OAreiqat/SDP23_Team5/SDP23_Team5_Website/assets/img/Team Members/Shira.jpg

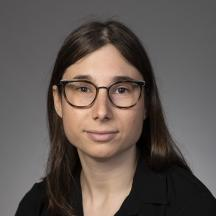
SDP23_Team5_Website/assets/img/Team Members/Shira.jpg
