OAreiqat/SDP23_Team5/SDP23_Team5_Website/assets/docs/CDR_Presentation.pdf

# CDR

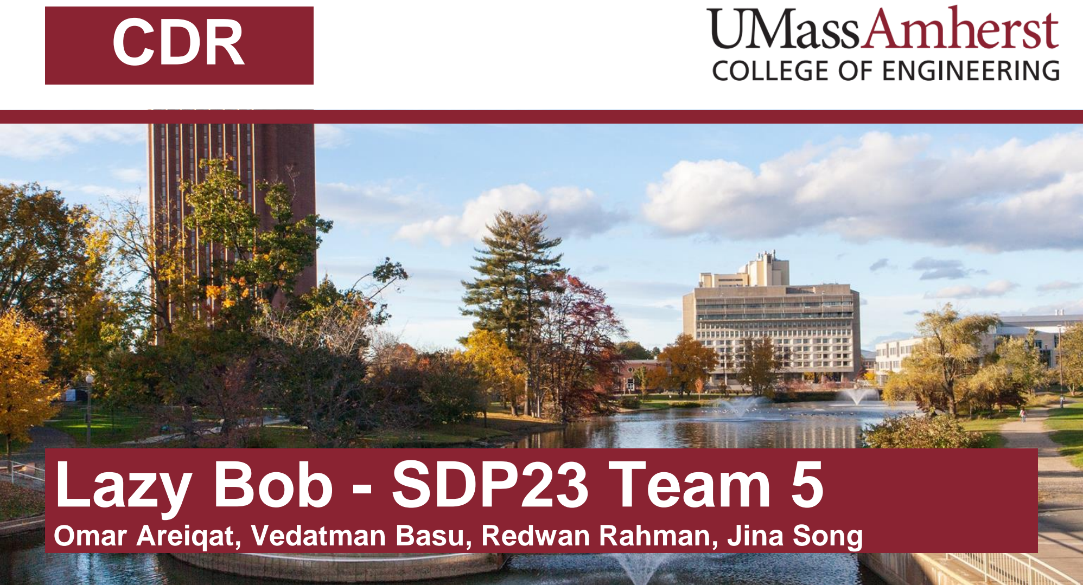
[picture p7: page 1]

# Lazy Bob - SDP23 Team 5

## Omar Areiqat, Vedatman Basu, Redwan Rahman, Jina Song

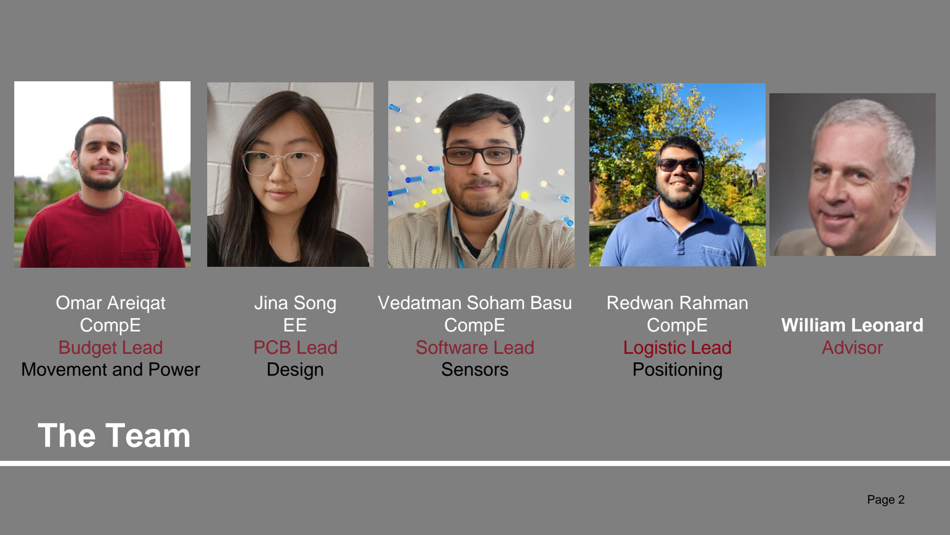
[picture p8: page 2]

# The Team

Omar Areiqat
CompE
Budget Lead
Movement and Power

Jina Song
EE
PCB Lead
Design

Vedatman Soham Basu
CompE
Software Lead
Sensors

Redwan Rahman
CompE
Logistic Lead
Positioning

William Leonard
Advisor

# Problem Statement

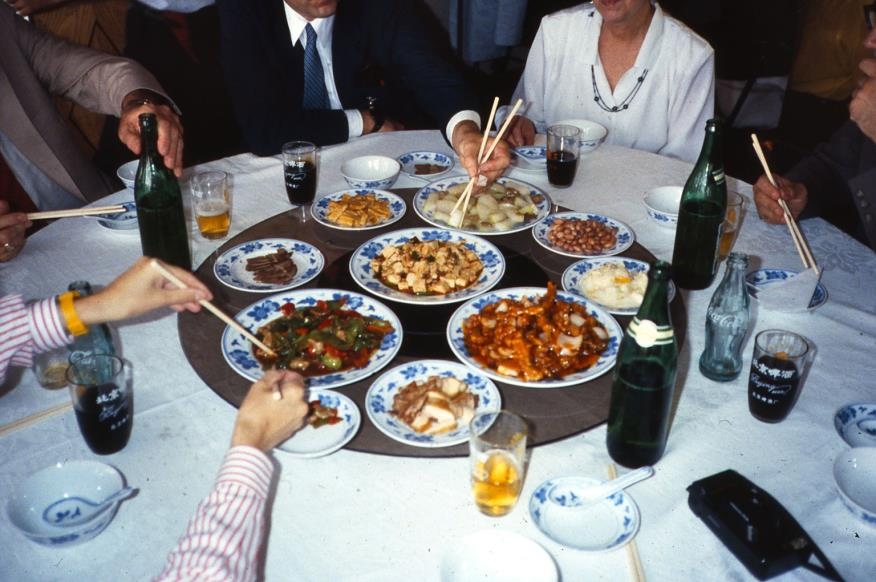
[picture p9: figure]

## Some people struggle with mundane actions in life, such as passing dishes on

a large table.

## Lazy Susans are nice, but only work on round tables and requires user to have

reach.

## What if there was a small, portable device that can move dishes across any table of arbitrary shape?

https://en.wikipedia.org/wiki/Lazy_Susan Page 3

# Our Solution

## “Lazy Bob”: A moving coaster that approaches the user when

called.

## 1. Stably transport items around a table to different users

## 1. Provide a simple way to interface with all coasters

## 1. Adapt to the environment

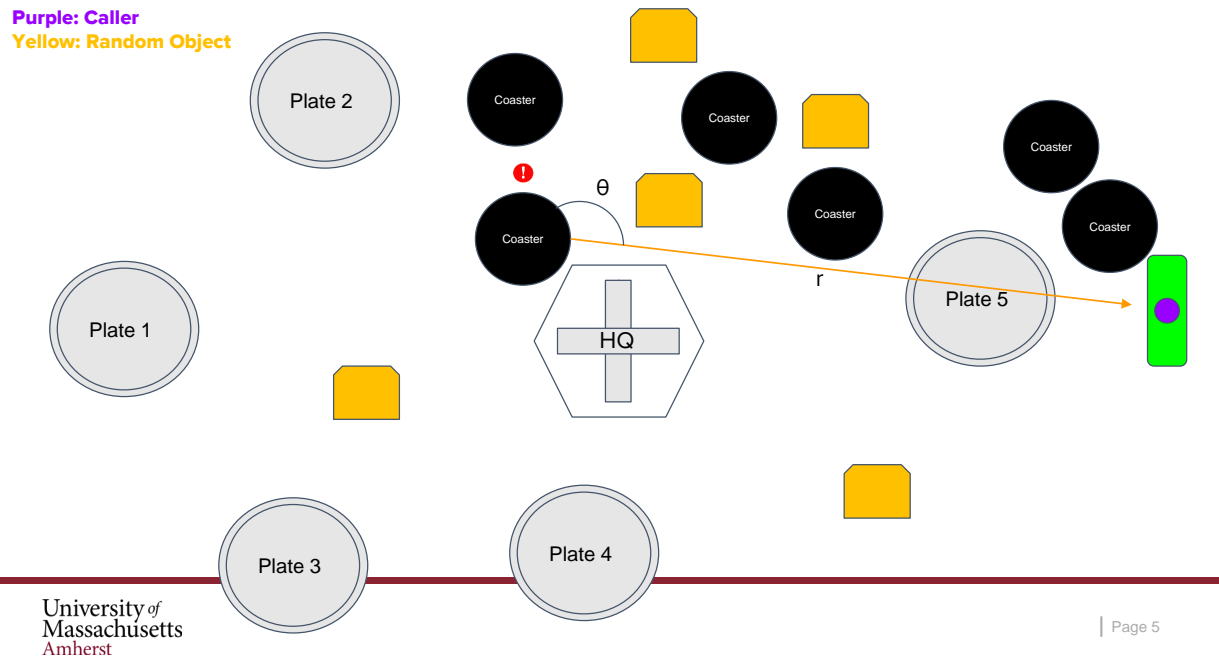
[picture p10: page 5]
Coaster; Plate 5; Plate 3; Plate 1; Plate 4; Plate 2

Purple: Caller
Yellow: Random Object

# Functional and Design

# Specification

# System Specifications: Functional

1. Mostly full container of liquid doesn’t spill when
moving
1. Transport items without the items falling off
1. Detect the edges of the table and avoid falling off
1. Avoid objects that are in the coaster’s moving path
1. Arrive at the caller to an accuracy of 10 cm from the edge of the coaster
1. Support up to 3 lbs.

### Test Plan

1. Place an 80% full glass/bowl of water and visibly check that the moving coaster doesn’t spill
1. Put objects on moving coaster and watch if object falls
1. Watch if the moving coaster falls off when caller is away from the table
1. Put objects in path and check if moving coaster bumps into object
1. Use a tape measure to check the distance from destination
1. Place an object that weighs 3 lbs and check if system is stable while moving

# System Specifications: Design

### Test Plan

7. Press both callers and see if the coaster follows
first-in, first-out sequence
8. Use tape measure to check coaster size
9. Find and put on irregular shaped tables and check
if they fall off
10. Line up objects to allow no path to caller, see if
system notifies caller
7. System supports at least 2 callers at the same
time
8. Coaster diameter is within 30 cm
9. Be able to use the moving coaster regardless of
table shape
10. If no path to caller is available, indicate to caller

# Block Diagrams

# Hardware Block Diagram

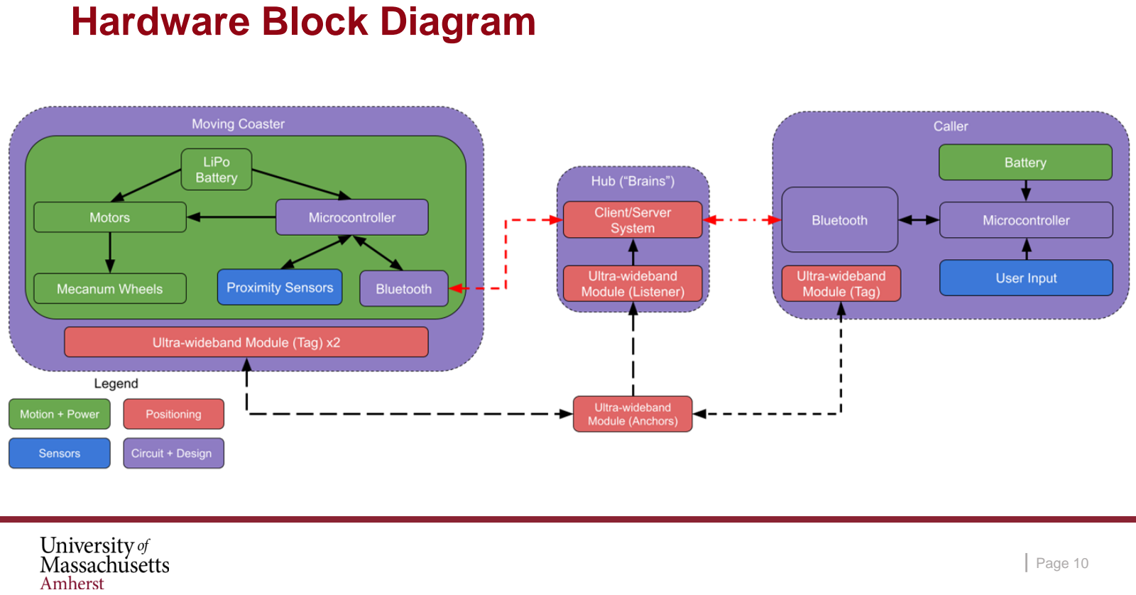
[picture p11: page 10]

# Software Block Diagram

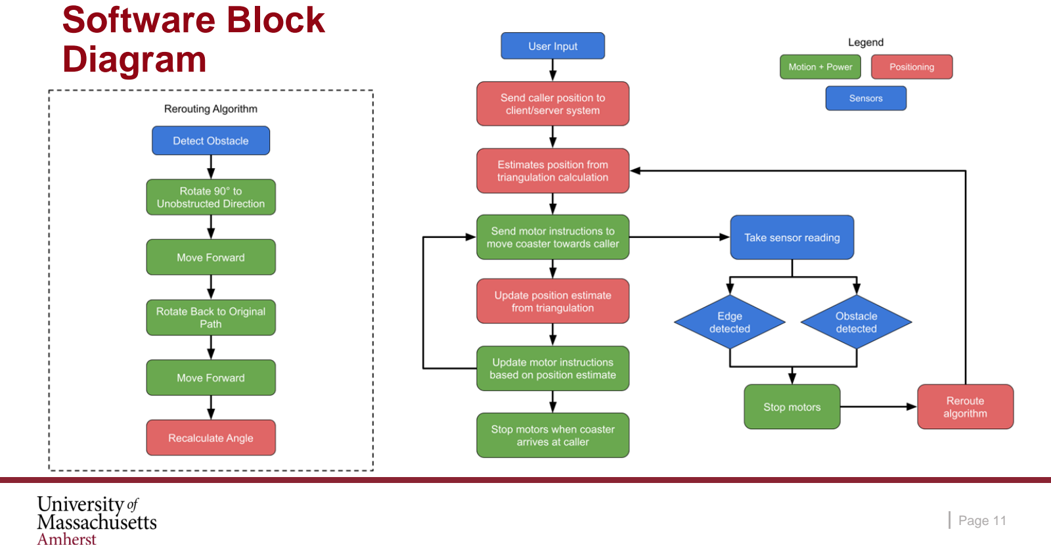
[picture p12: page 11]

# System Hardware

# Coaster

# Coaster: MDR

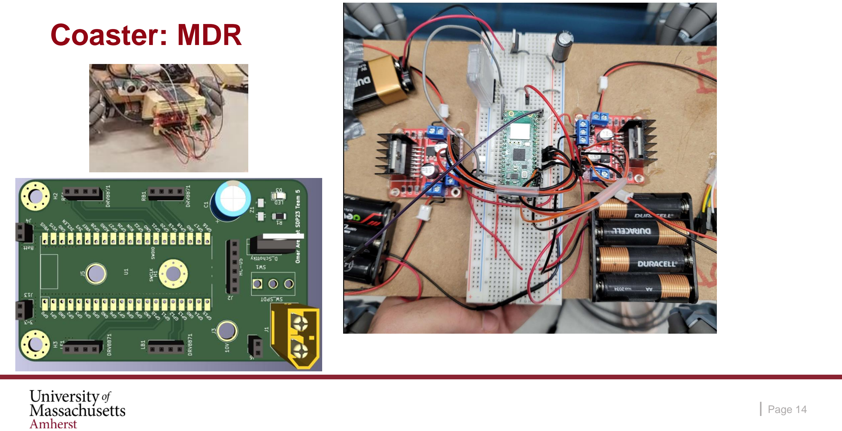
[picture p13: page 14]

# Coaster: CDR

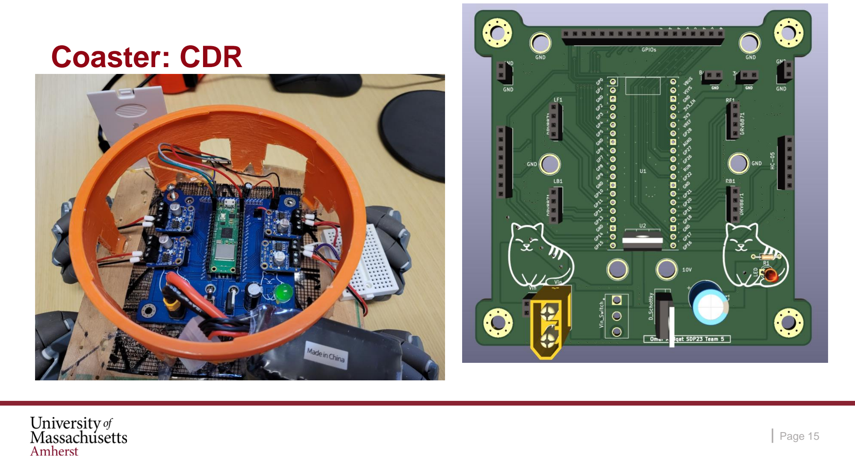
[picture p14: page 15]

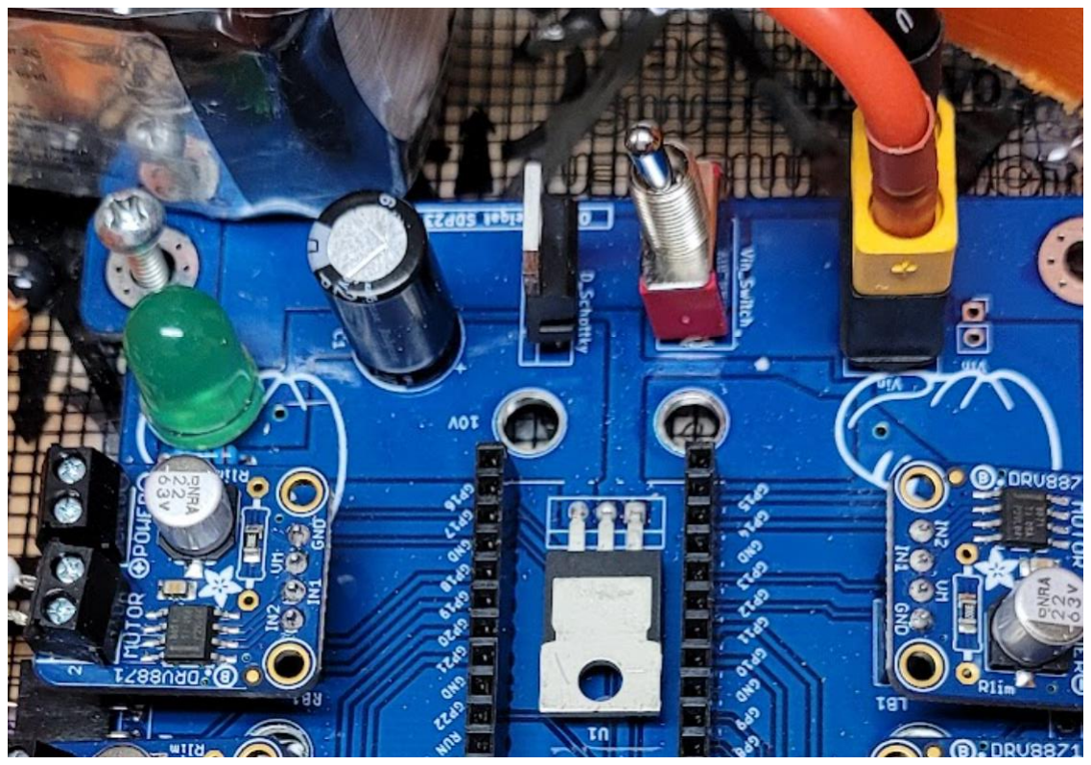
[picture p15: figure]

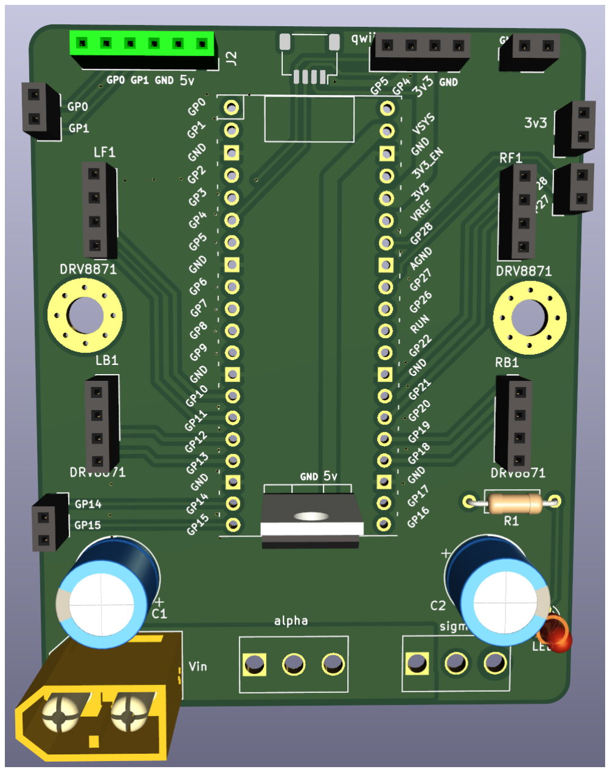
[picture p16: figure]

# Coaster: FPR PCB

# Caller

# Subsystem: Caller PCB

MDR | CDR | FPR

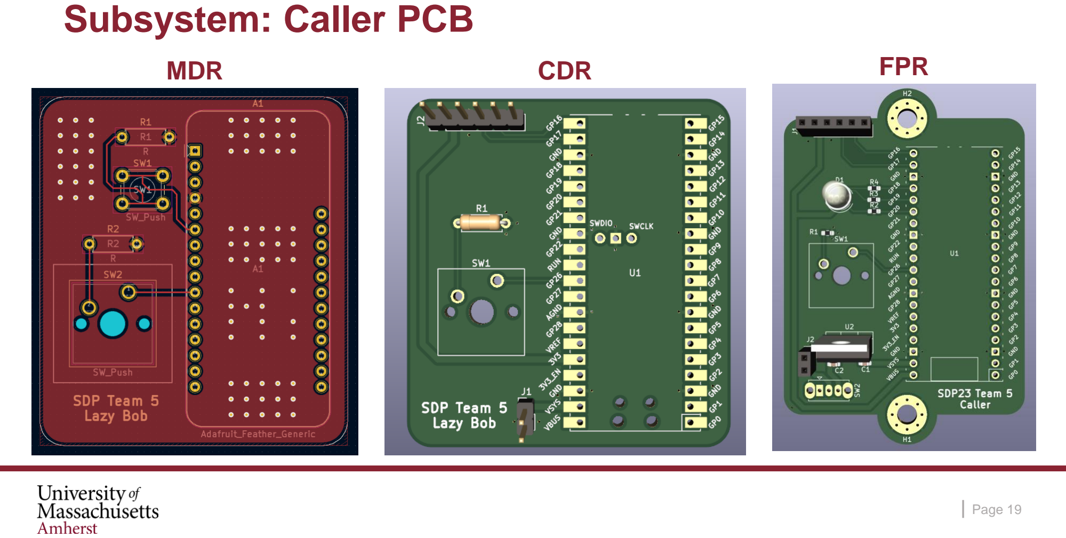
[picture p17: page 19]

# Sensors

# Subsystem: Collision and Cliff Detection

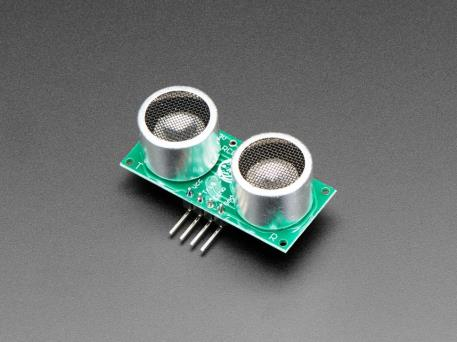
[picture p18: figure]

## - Ultrasonic

## - Collision detection (CDR) - Has not changed from before

## - Light ToF

## - Edge Detection (CDR) - Collision Detection (FPR) - Easy to implement many at a time

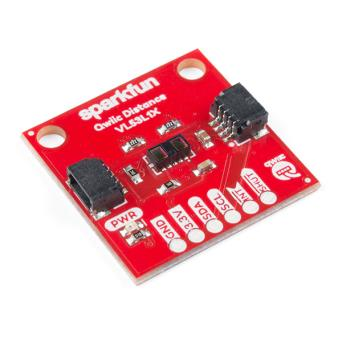
[picture p19: figure]

https://www.sparkfun.com/products/14722 Page 21

# Positioning and Rerouting

## - Ultra Wideband Sensor

# Subsystem: Positioning

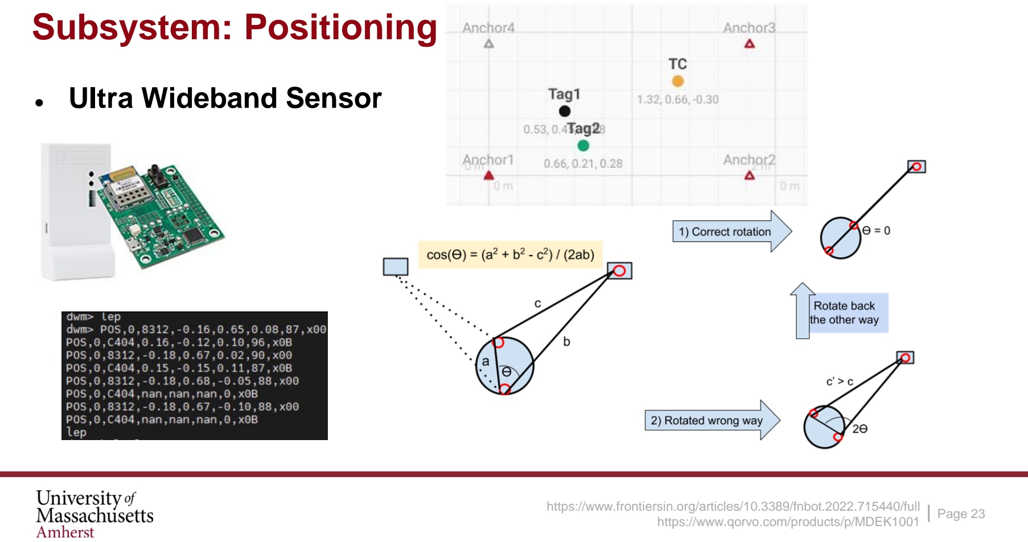
[picture p20: page 23]

https://www.frontiersin.org/articles/10.3389/fnbot.2022.715440/fullhttps://www.qorvo.com/products/p/MDEK1001 Page 23

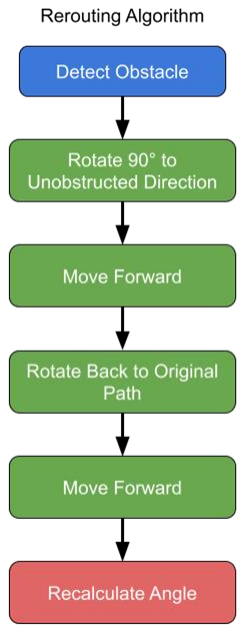
[picture p21: figure]

# Rerouting Block Diagram

# Subsystem: Algorithm

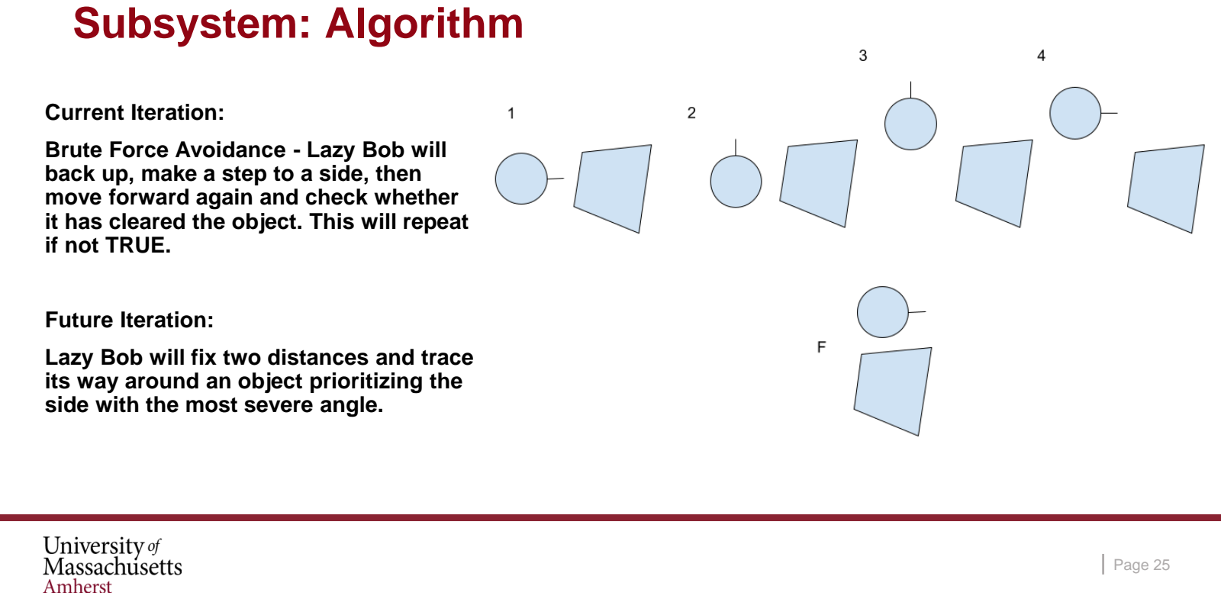
[picture p22: page 25]

Current Iteration:

Brute Force Avoidance - Lazy Bob will back up, make a step to a side, then move forward again and check whether it has cleared the object. This will repeat if not TRUE.

Future Iteration:

Lazy Bob will fix two distances and trace its way around an object prioritizing the side with the most severe angle.

# FPR Deliverables

## 1. Improved consistency on movement

## a. Move movement controls to the coaster itself for better consistency

## 1. Better Rerouting Algorithm

## a. Using more sensors, implement a better way to navigate

## 1. 2nd Caller

## 4. Chassis for Coaster

## a. 3D print chassis for each part of the system

## 5. PCB Plans

## a. Motion - Further optimizations

## b. User input - Add 5V and LED

# Design: Chassis (FPR)

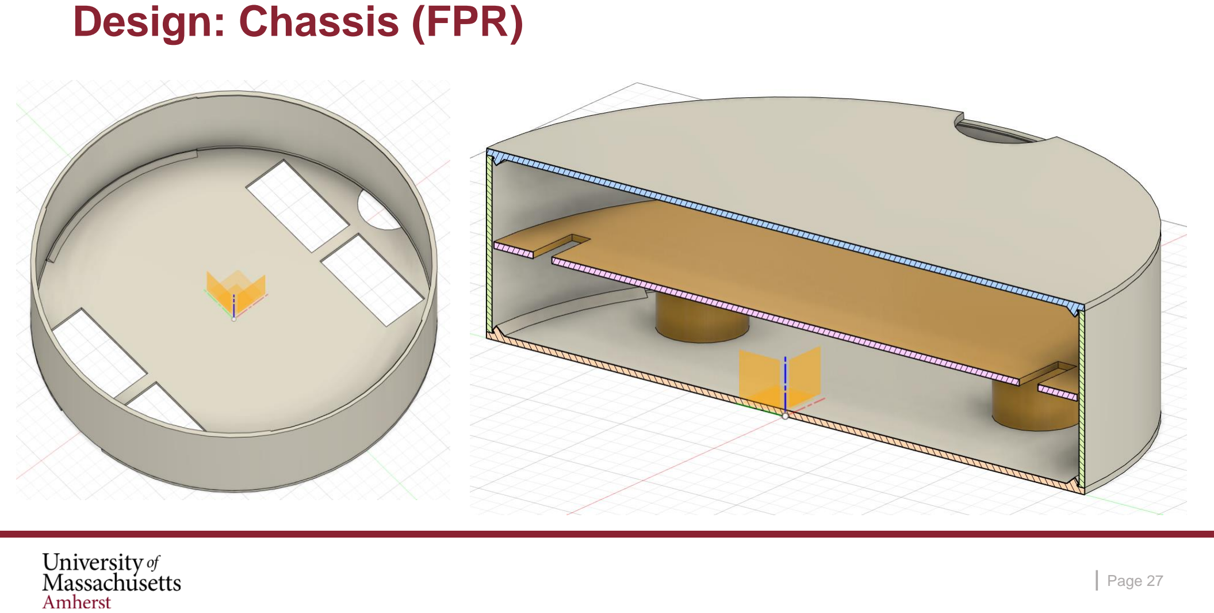
[picture p23: page 27]

# Design: Chassis (FPR)

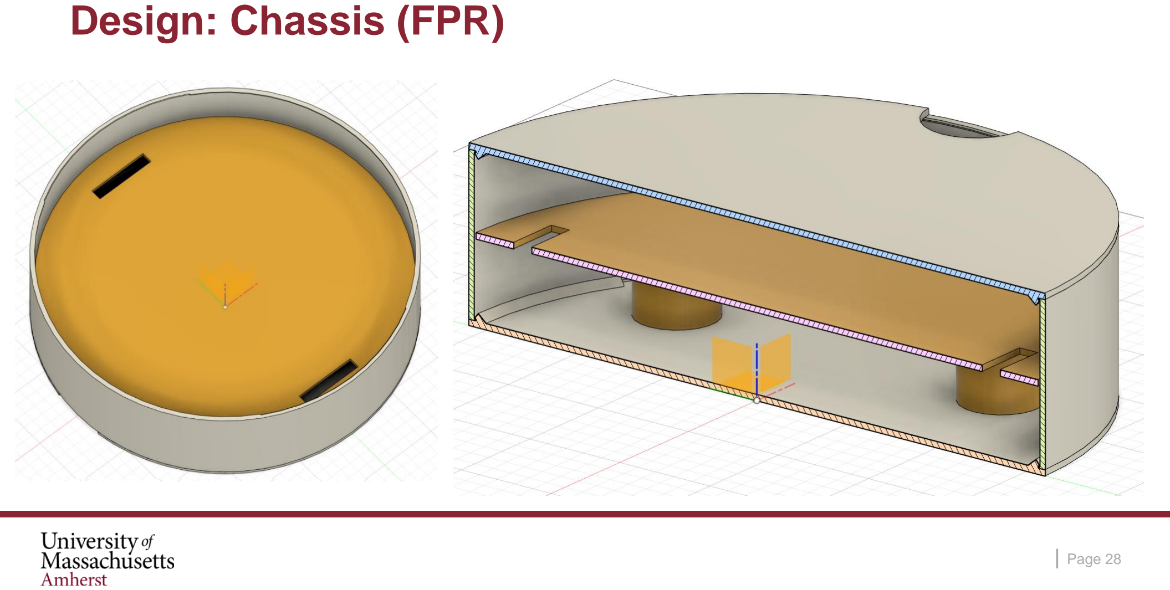
[picture p24: page 28]

# Design: Chassis (FPR)

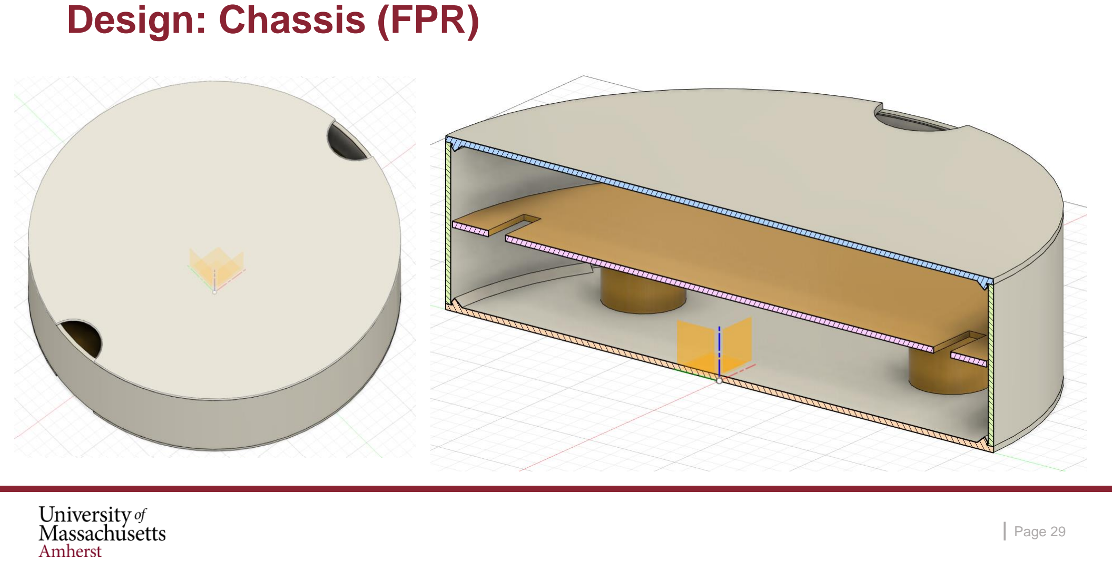
[picture p25: page 29]

# SDP Budget Used

Purchasing List
Item Name | Link | Price $ (w/Tax & Ship)
UWB DIY Starter Kit | Tindie (https://www.tindie.com/products/petteemfg/ultra-wideband-rtls-uwb-diy-starter-kit/) | 74.98
2 x Pico W | Digikey | 12
Gina PCB1 | JLC | 22.05
Gina PCBs 2 | JLC | 15.44
Omar PCB1 | JLC | 6.5
Omar PCB2 | JLC | 6.76
6 Dof Sensors | Amazon | 15.95
10x HC05 | Amazon | 37.98
3D Filament | Amazon | 38.99
New Wheels | Adafruit | 28.17
$258.82

Development Cost - per set of Brains, 1 Coaster, and 2 Callers

Coaster List
Item Name | Source | Price $ (with tax and shipping)
Qorvo UWB Kit | Qorvo | 170
3 x Pico W | Wouter | 18
PCBs | JLCPCB | 10
Sensors | M5 | 25
Sensors | M5 | 25
8x RCR132a | Amazon | 27
Motors and Wheels | Amazon | 50
Raspberry Pi 4 | M5 | 100
Misc. Hardware | Misc | 30
Lipo | M5 | 20
$475.00

# Gantt Chart

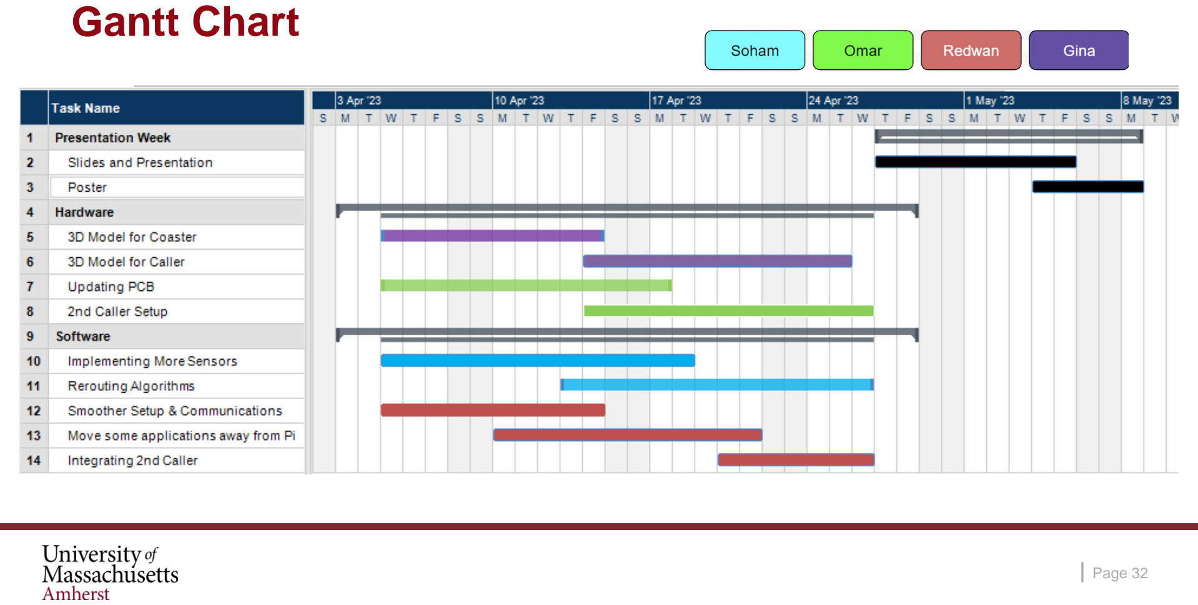
[picture p26: page 32]

# Videos

## Straight Shot:

https://drive.google.com/file/d/141u86p3lzujfCnuI5bPtXzJ-QYSLi3L_/view?usp=sharing

## Obstacle Avoidance:

https://drive.google.com/file/d/14BBHoazjFHobzXkXQCEPxUCetjSHFlHe/view?usp=sharing

# QUESTIONS & ANSWERS

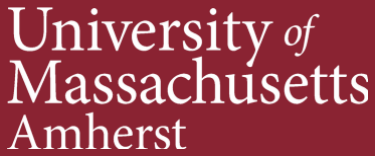
[picture p27: figure]
