OAreiqat/SDP23_Team5/SDP23_Team5_Website/assets/docs/FPR_Presentation.pdf

# FPR

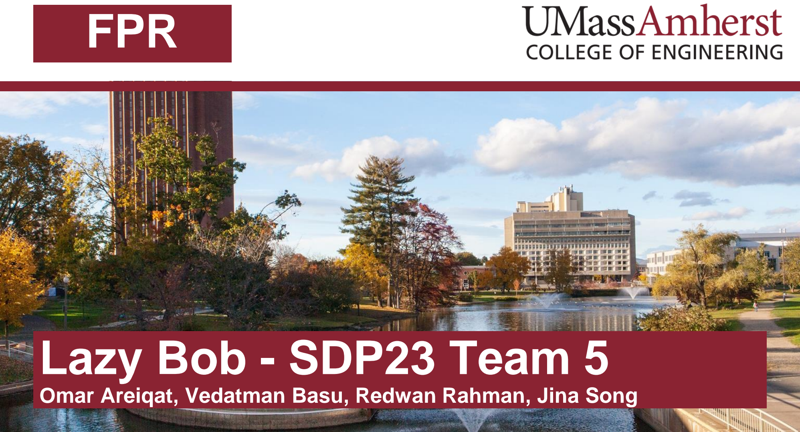
[picture p28: page 1]

# Lazy Bob - SDP23 Team 5

## Omar Areiqat, Vedatman Basu, Redwan Rahman, Jina Song

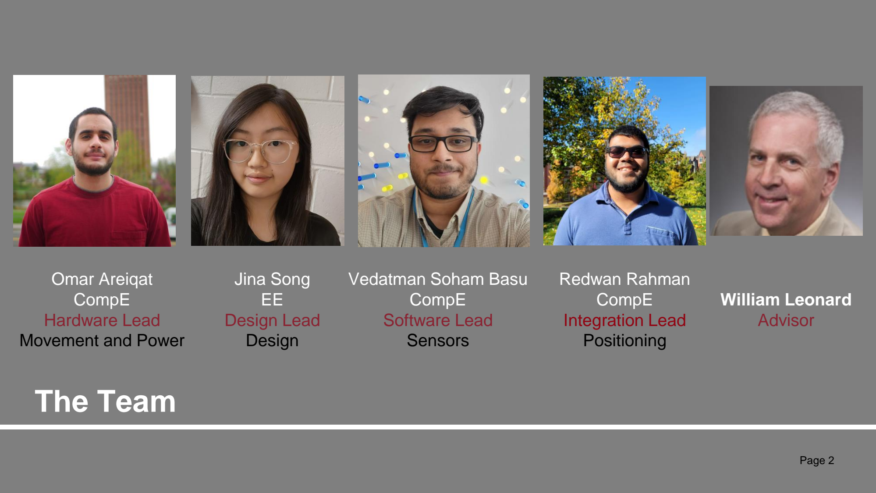
[picture p29: page 2]

# The Team

Omar Areiqat
CompE
Hardware Lead
Movement and Power

Jina Song
EE
Design Lead
Design

Vedatman Soham Basu
CompE
Software Lead
Sensors

Redwan Rahman
CompE
Integration Lead
Positioning

William Leonard
Advisor

# Problem Statement


## Some people struggle with mundane actions in life, such as passing dishes on

a large table.

## Lazy Susans are nice, but only work on round tables and requires user to have

reach.

## What if there was a small, portable device that can move dishes across any table of arbitrary shape?

https://en.wikipedia.org/wiki/Lazy_Susan Page 3

# Our Solution

## “Lazy Bob”: A moving coaster that approaches the user when

called.

## 1. Stably transport items around a table to different users

## 1. Provide a method for the user to call the moving coaster

## 1. Adapt to the environment

# Proposed System

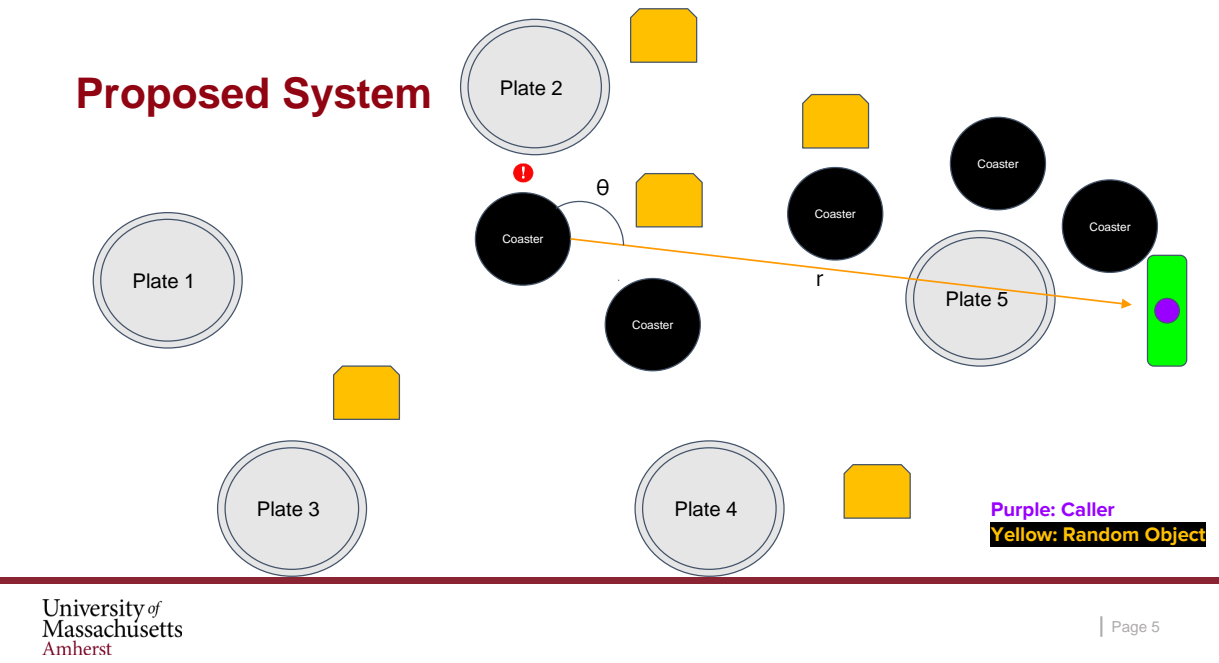
[picture p30: page 5]
Coaster; Plate 5; Plate 3; Plate 1; Plate 4; Plate 2

Purple: Caller
Yellow: Random Object

# Delivered System

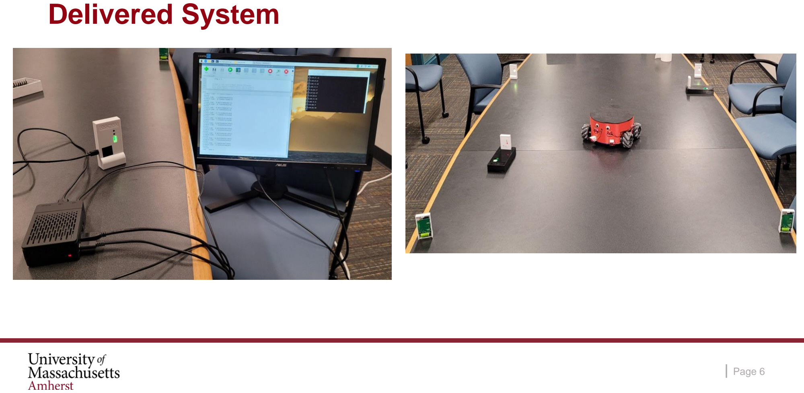
[picture p31: page 6]

## Pic of pi + monitor

## Overview shot

# System Specification

# System Specifications

1. Mostly full container of liquid doesn’t spill when moving
1. Transport items without the items falling off
1. Detect the edges of the table and avoid falling off
1. Avoid objects that are in the coaster’s moving path
1. Arrive at the caller to an accuracy of 15 cm between the closest points of the coaster and caller

### Test Plan

1. Place an 80% full glass/bowl of water and visibly check that the moving coaster doesn’t spill
1. Put objects on moving coaster and watch if object falls
1. Watch if the moving coaster falls off when caller is away from the table
1. Put objects in path and check if moving coaster bumps into object
1. Use a tape measure to check the distance from destination

# System Specifications

### Test Plan

6. Place an object that weighs 3 lbs and check if
system is stable while moving
7. Press both callers and see if the coaster moves
to the first caller only
8. Use tape measure to check coaster size
9. Find and put on irregular shaped tables and check
if it falls off
6. Support up to 3 lbs
7. System supports at least 2 callers at the same
time
8. Coaster diameter is within 30 cm
9. Be able to use the moving coaster regardless of
table shape

# Block Diagrams

# Hardware Block Diagram

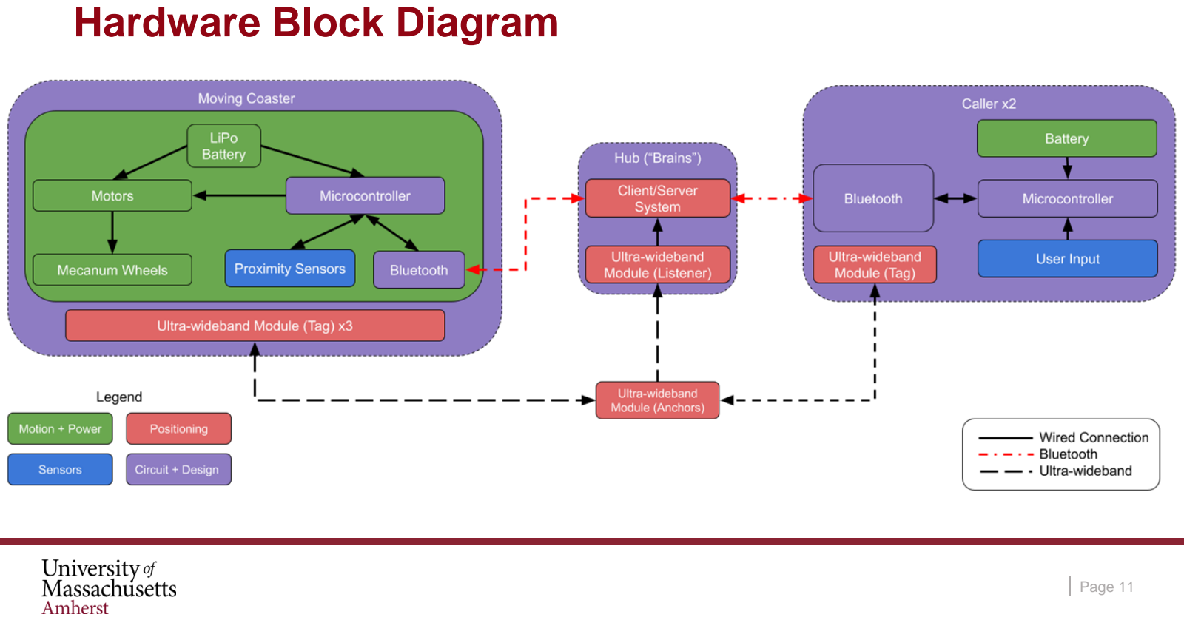
[picture p32: page 11]

# Software Block Diagram

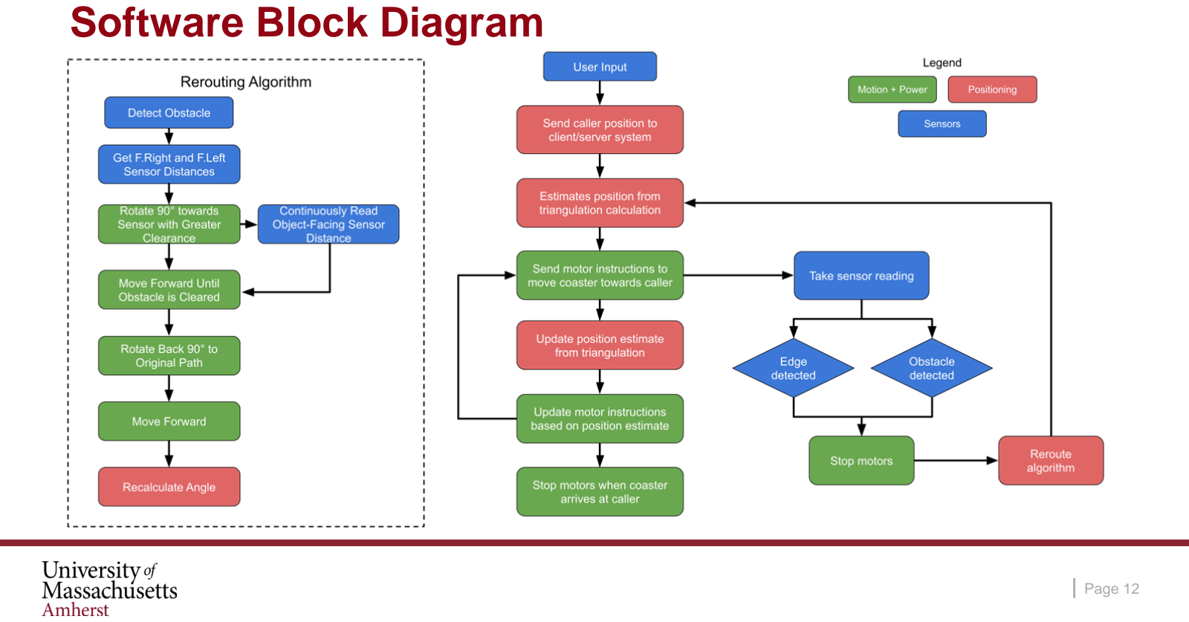
[picture p33: page 12]

# System Hardware

# Coaster

# Coaster: MDR

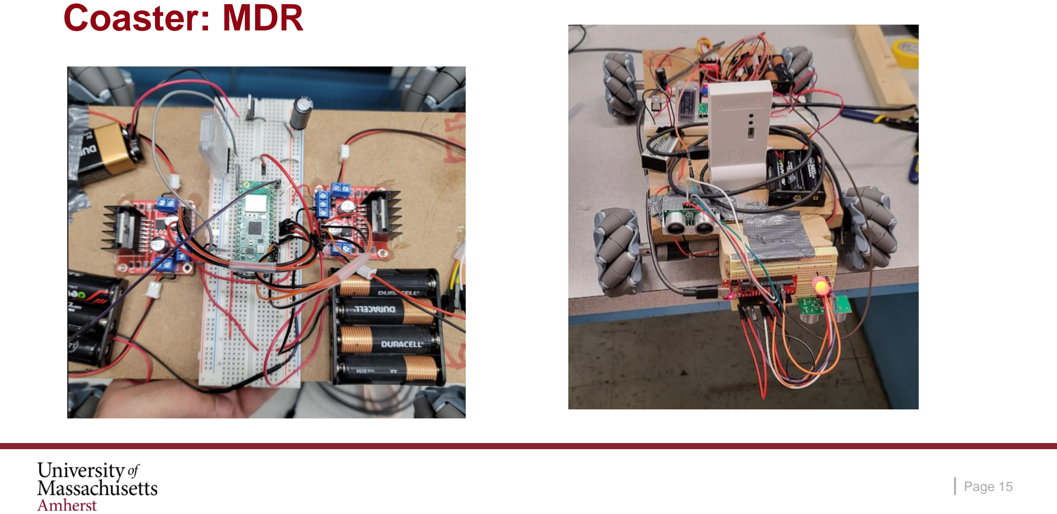
[picture p34: page 15]

# Coaster: CDR

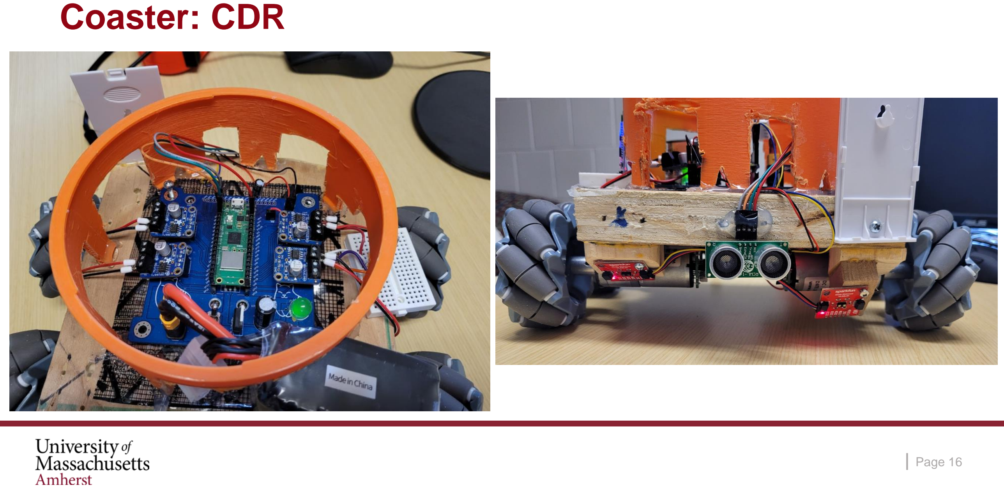
[picture p35: page 16]

# Coaster: FPR

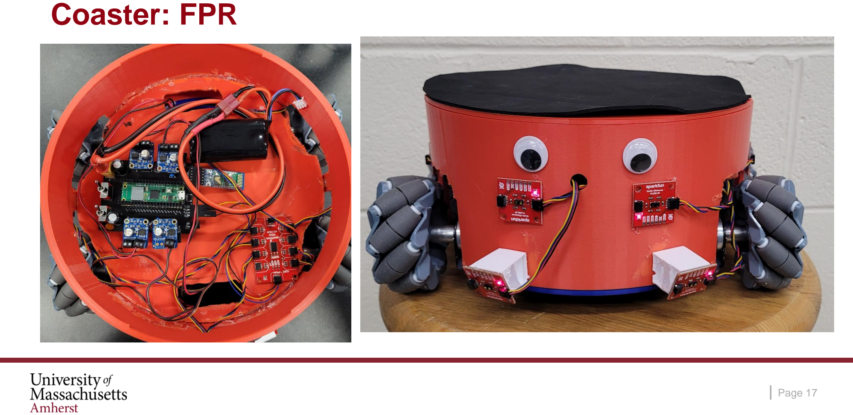
[picture p36: page 17]

# Callers

# Callers: MDR

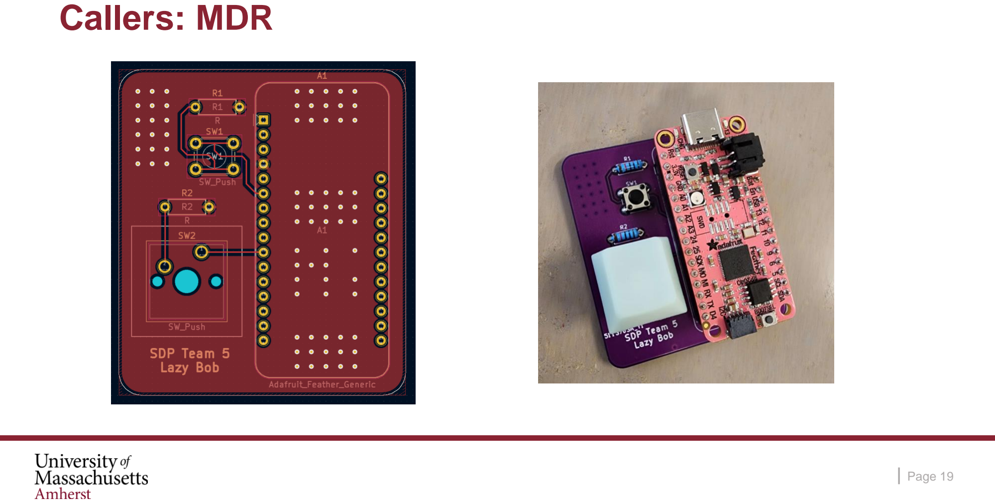
[picture p37: page 19]

# Callers: CDR

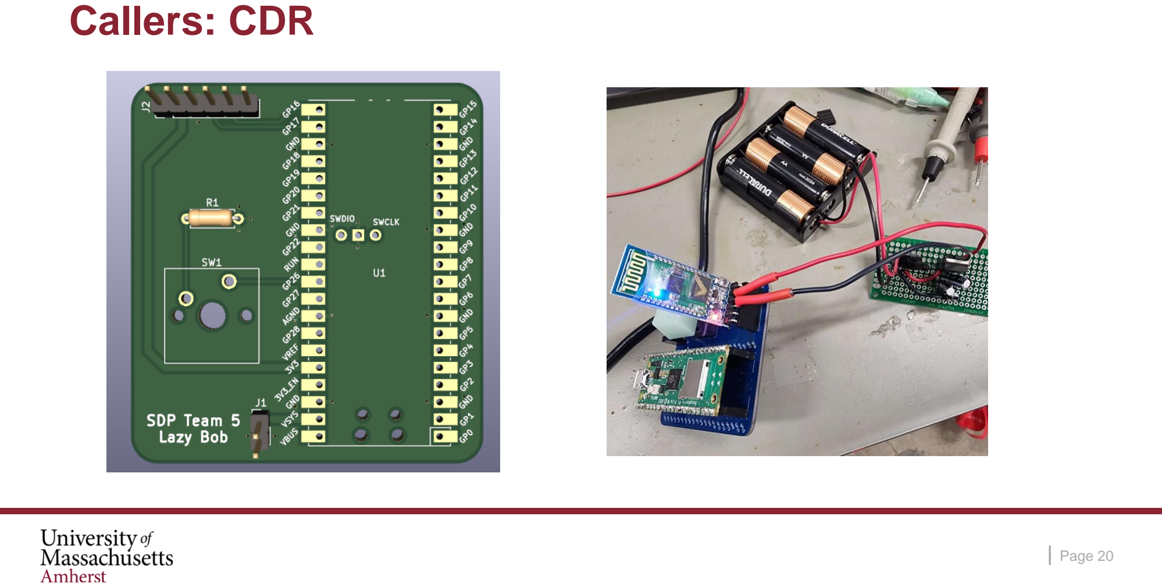
[picture p38: page 20]

# Callers: FPR

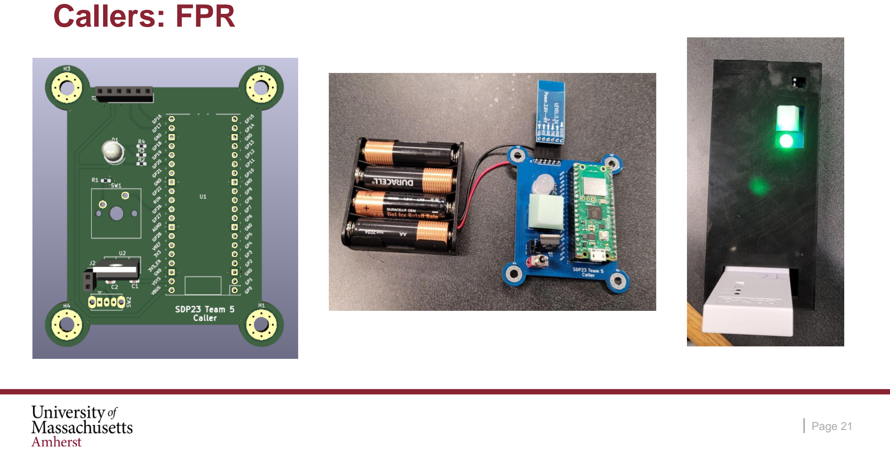
[picture p39: page 21]

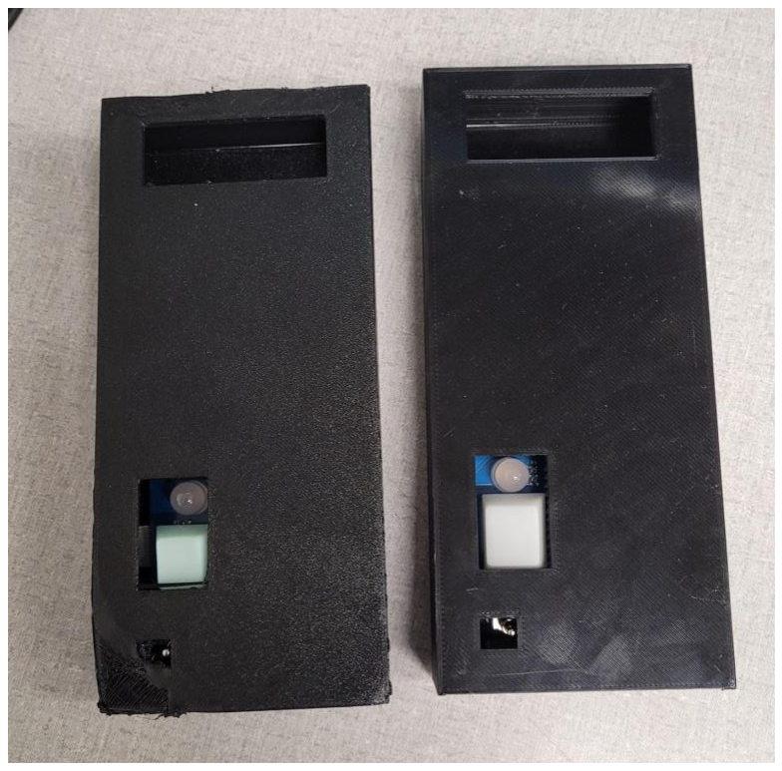
[picture p40: figure]

## - Only 1 caller may request the coaster at a time

## - All other calls are ignored when in use

## - LED color signifies current status

## - Green = Ready - Blue = On The Way - Red = Busy

# Callers: Multiple Implementation

# The “Brains”

# The “Brains”

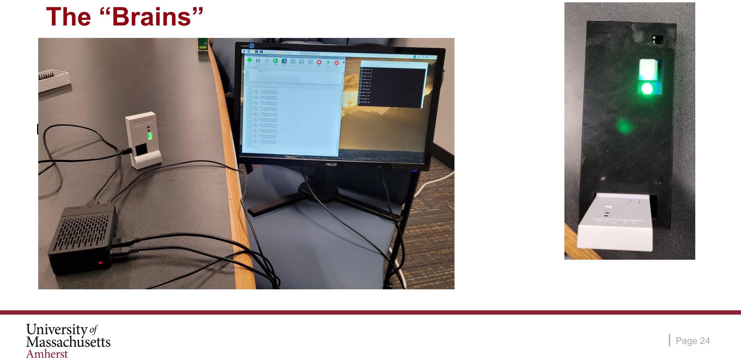
[picture p41: page 24]

Insert picture of pi

# Sensors

# Sensors: Collision and Cliff Detection

## - Light ToF

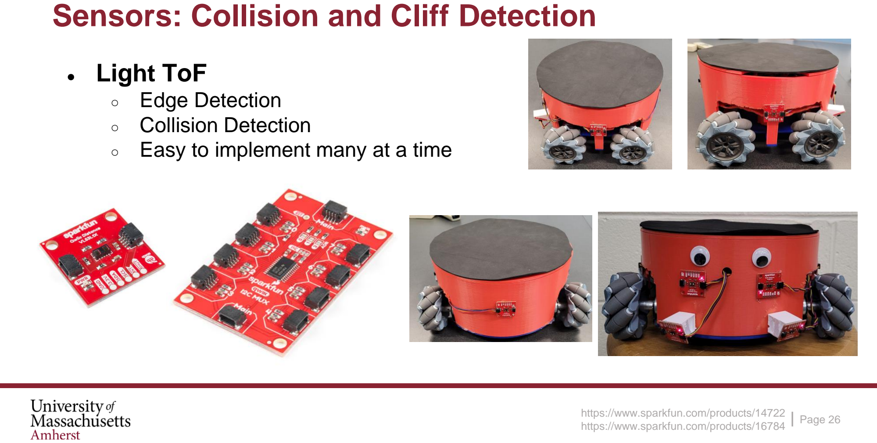
[picture p42: page 26]

## - Edge Detection - Collision Detection - Easy to implement many at a time

https://www.sparkfun.com/products/14722https://www.sparkfun.com/products/16784 Page 26

# Positioning and Rerouting

# Positioning: Ultra-wideband

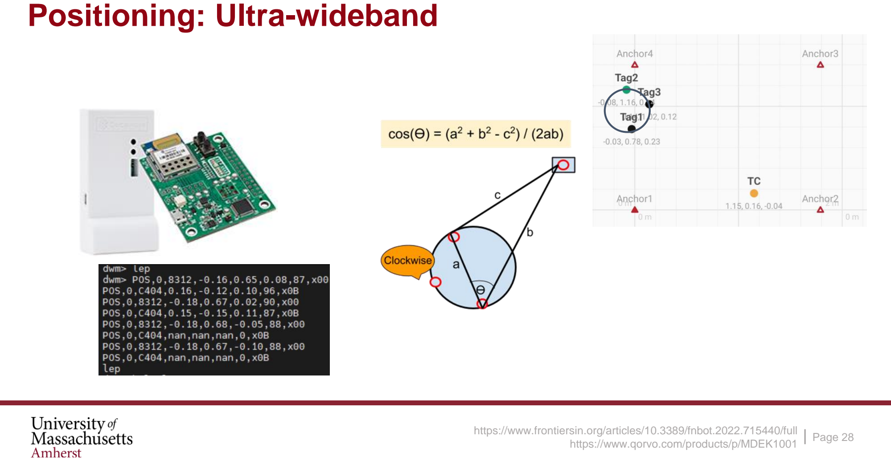
[picture p43: page 28]

https://www.frontiersin.org/articles/10.3389/fnbot.2022.715440/fullhttps://www.qorvo.com/products/p/MDEK1001 Page 28

# Rerouting Algorithm

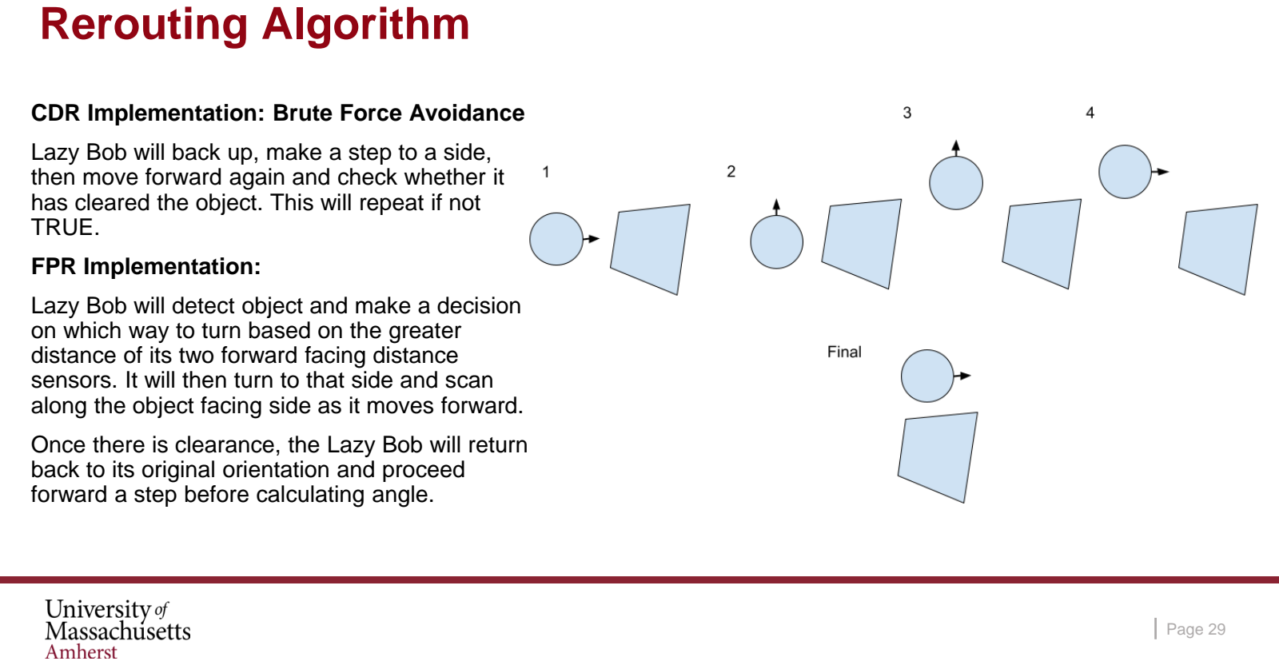
[picture p44: page 29]

CDR Implementation: Brute Force Avoidance

Lazy Bob will back up, make a step to a side, then move forward again and check whether it has cleared the object. This will repeat if not TRUE.

FPR Implementation:

Lazy Bob will detect object and make a decision on which way to turn based on the greater distance of its two forward facing distance sensors. It will then turn to that side and scan along the object facing side as it moves forward.

Once there is clearance, the Lazy Bob will return back to its original orientation and proceed forward a step before calculating angle.

# Costs

# SDP Budget Used

Obtained List
Item Name | Source | Price $
UWB DIY Starter Kit | Link (https://www.tindie.com/products/petteemfg/ultra-wideband-rtls-uwb-diy-starter-kit/) | $74.98
2 x Pico W | Wouter | $12.00
Caller PCB1 | Wouter | $22.05
6 Dof Sensors | Amazon | $15.95
New Wheels | Adafruit | $28.17
Coaster PCB1 | JLC | $6.50
Coaster PCB2 | JLC | $6.76
10 x HC05 | Amazon | $37.98
Caller PCB2 | JLC | $15.44
3D Filament | Amazon | $38.99
VL53l1x | Sparkfun | $113.81
FPR PCBs | JLC | $27.84
LiPo Battery | amazon | $24.99
Wheels | amazon | $44.99
3D Filament | Amazon | $24.99
Motors | Amazon | $43.56
$539.00

Production Cost - for 1 Brains, 1 Coaster, and 2 Callers

Mass Production List
Item Name | Units | $ Unit Price | $ Item Total
UWB Sensor | 10 | $15.00 | $150.00
VL53L1X (Sensor) | 7 | $3.30 | $23.10
Pico W | 4 | $6.00 | $24.00
HC-05 (BLE Module) | 4 | $2.38 | $9.52
Coaster Chassis | 1 | $35.00 | $35.00
Caller Chassis | 2 | $7.00 | $14.00
Wheel | 4 | $3.00 | $12.00
PCB | 3 | $1.00 | $3.00
7.4V LiPo | 1 | $5.00 | $5.00
MUX | 1 | $0.60 | $0.60
Motor | 4 | $0.24 | $0.96
Cables | Misc. | $5.00 | $5.00
System Total: | 270.62

# Reminder of FPR Deliverables

## 1. Improved Consistency on Movement

## a. Move movement controls to the coaster itself for better consistency

## 1. Better Rerouting Algorithm

## a. Using more sensors, implement a better way to navigate

## 1. 2nd Caller

## 4. Chassis for Coaster

## a. 3D print chassis for each part of the system

## 5. Updated PCB

## a. Motion - Further optimizations

## b. User input - Add 5V and LED

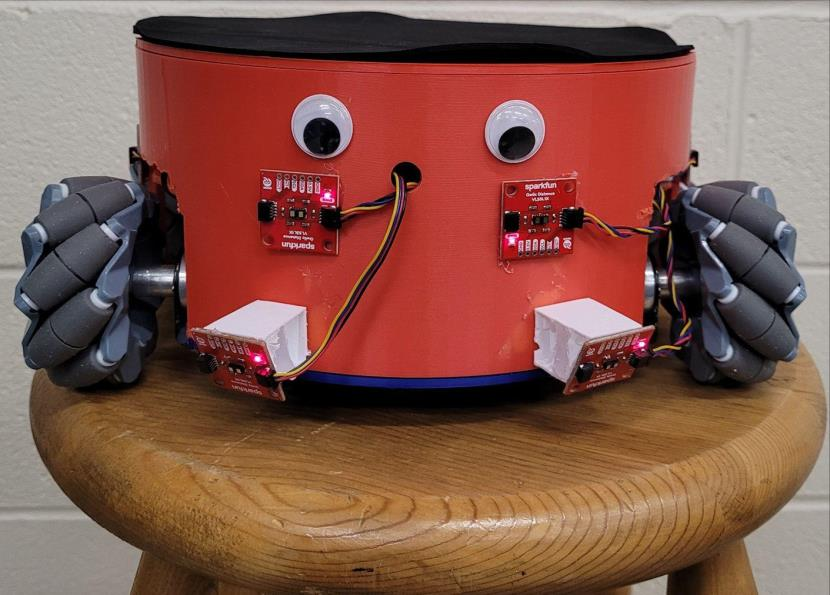
[picture p45: figure]
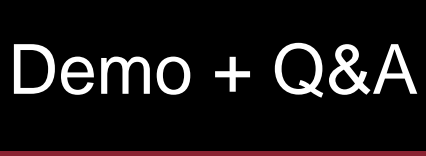
[picture p46: figure]
Demo + Q&A

# Videos

Straight Shot & Edge Detection & Button Colors & Button Locking:

https://drive.google.com/file/d/1MCR_ZY55AZKxfdinNN-QkkkYKjTHUI0m/view?usp=share_link

Obstacle Avoidance:

https://drive.google.com/file/d/1MJIGTPBW8F-LTN8W8kColtyC7Dfij1dU/view?usp=sharing

https://drive.google.com/file/d/1MNN1SpP66sIA2yZz_bj1Dcg2ajXkuQTa/view?usp=sharing
