OAreiqat/SDP23_Team5/SDP23_Team5_Website/assets/docs/MDR_Presentation.pdf

# MDR

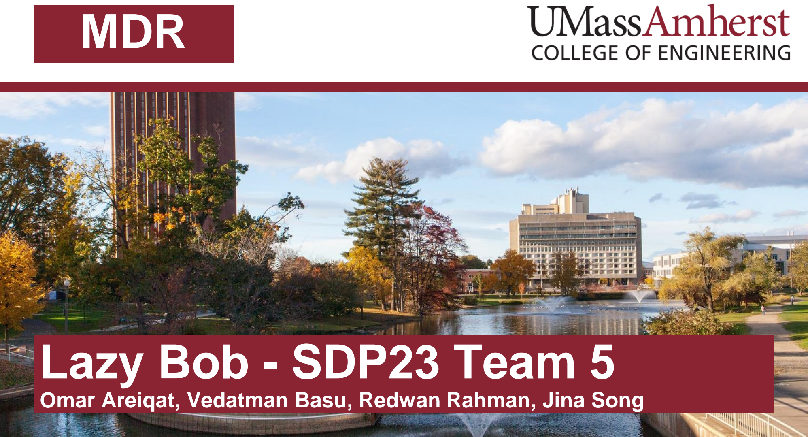
[picture p47: page 1]

# Lazy Bob - SDP23 Team 5

## Omar Areiqat, Vedatman Basu, Redwan Rahman, Jina Song


# The Team

Omar Areiqat
CompE
Budget Lead
Movement and Power

Jina Song
EE
PCB Lead
Design

Vedatman Soham Basu
CompE
Software Lead
Sensors

Redwan Rahman
CompE
Logistic Lead
Positioning

William Leonard
Advisor

# Problem Statement


## Some people struggle with mundane actions in life, such as passing dishes on

a large table.

## Lazy Susans are nice, but only work on round tables and requires user to have

reach.

## What if there was a small, portable device that can move dishes across any table of arbitrary shape?

https://en.wikipedia.org/wiki/Lazy_Susan Page 3

# Our Solution

## “Lazy Bob”: A moving coaster that approaches the user when

called.

## 1. Stably transport items around a table to different users

## 1. Provide a simple way to interface with all coasters

## 1. Adapt to the environment

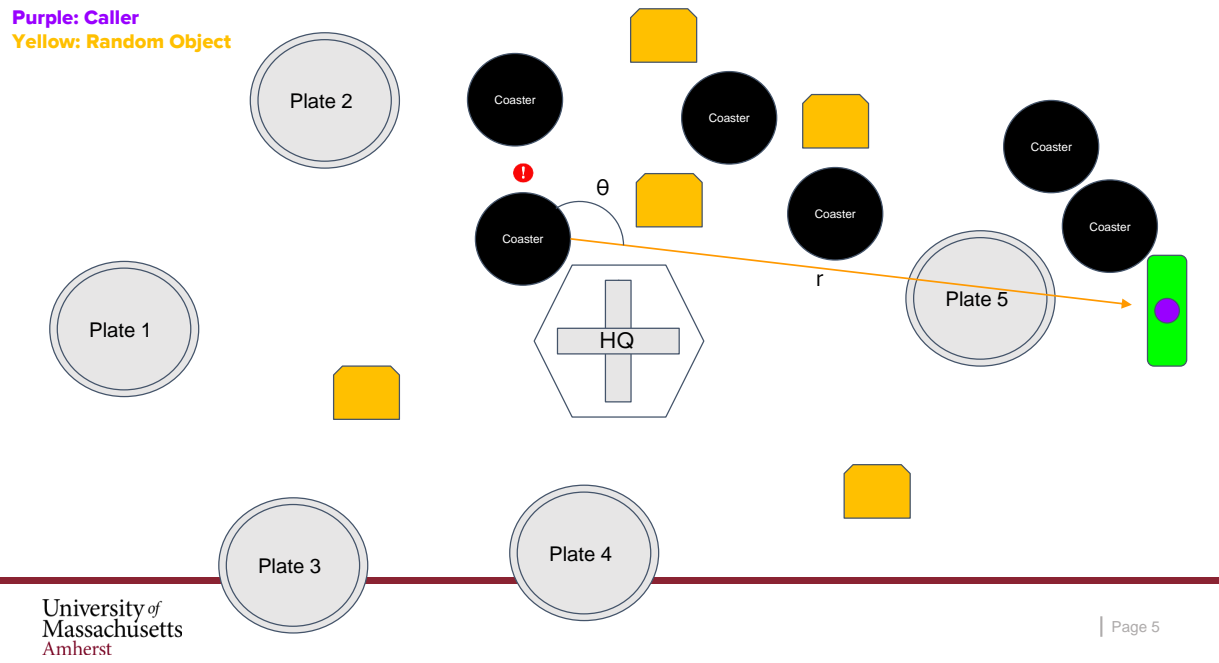
[picture p48: page 5]
Coaster; Plate 5; Plate 3; Plate 1; Plate 4; Plate 2

Purple: Caller
Yellow: Random Object

# System Specifications: Functional

1. Mostly full container of liquid doesn’t spill when
moving
1. Transport items without the items falling off
1. Detect the edges of the table and avoid falling off
1. Avoid objects that are in the coaster’s moving path
1. Arrive at the caller or hub to an accuracy of 10 cm
1. Support up to 3 lbs.

### Test Plan

1. Place an 80% full glass/bowl of water and visibly check that the moving coaster doesn’t spill
1. Put objects on moving coaster and watch if object falls
1. Watch if the moving coaster falls off when caller is away from the table
1. Put objects in path and check if moving coaster bumps into object
1. Use a tape measure to check the distance from destination
1. Place an object that weighs 3 lbs and check if system is stable while moving

# System Specifications: Design

### Test Plan

7. Watch the moving coaster move towards hub on a
given signal
8. Call both coasters on a collision course and see if
they collide
9. Use tape measure to check coaster size
10. Find and put on irregular shaped tables and check
if they fall off
11. Line up objects to allow no path to caller, see if
system notifies caller
7. Move back to the coaster’s hub once determined
not in use
8. System supports at least 2 coasters at the same
time
9. Coaster diameter is within 25 cm
10. Be able to use the moving coaster regardless of
table shape
11. If no path to caller is available, indicate to caller

# MDR Deliverables

## A. 1 Moving Coaster

## a. Moves properly and accurately b. Accurately detects positioning c. Goes to location when called d. Detects and stops if an object is in the way

## A. 1 Caller

## a. Can send signal to coaster and hub

## A. 1 Charging Hub - “Brains”

## a. Can send signal to coaster and callers b. Potentially charges system

## D. Functional PCB

## a. Microcontroller with user input method (button)

# Hardware Block Diagram

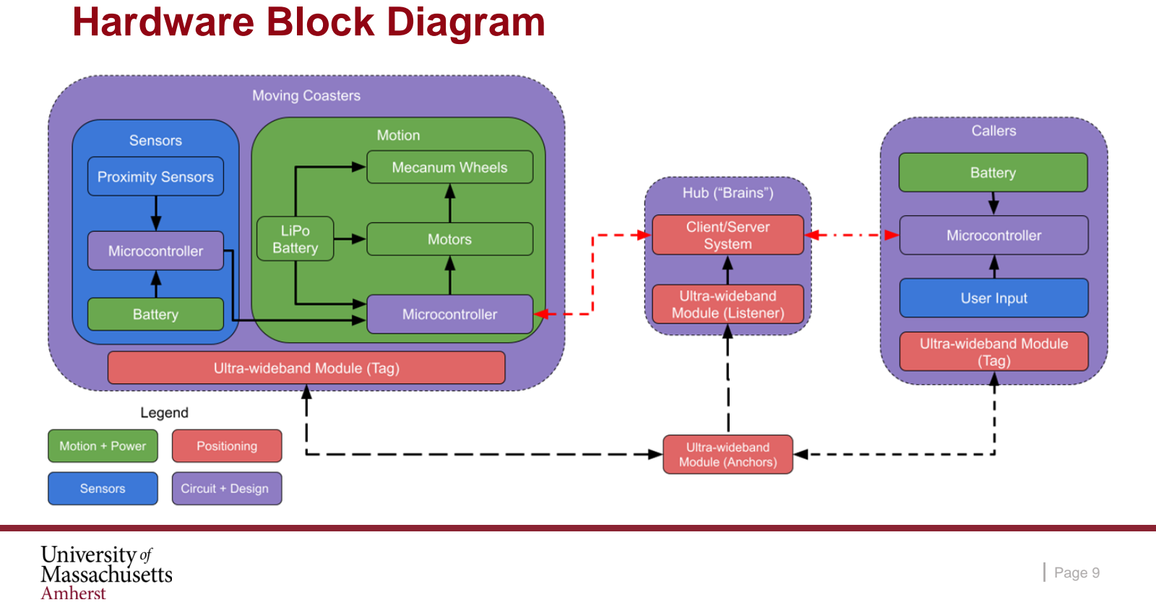
[picture p49: page 9]

# Software Block Diagram

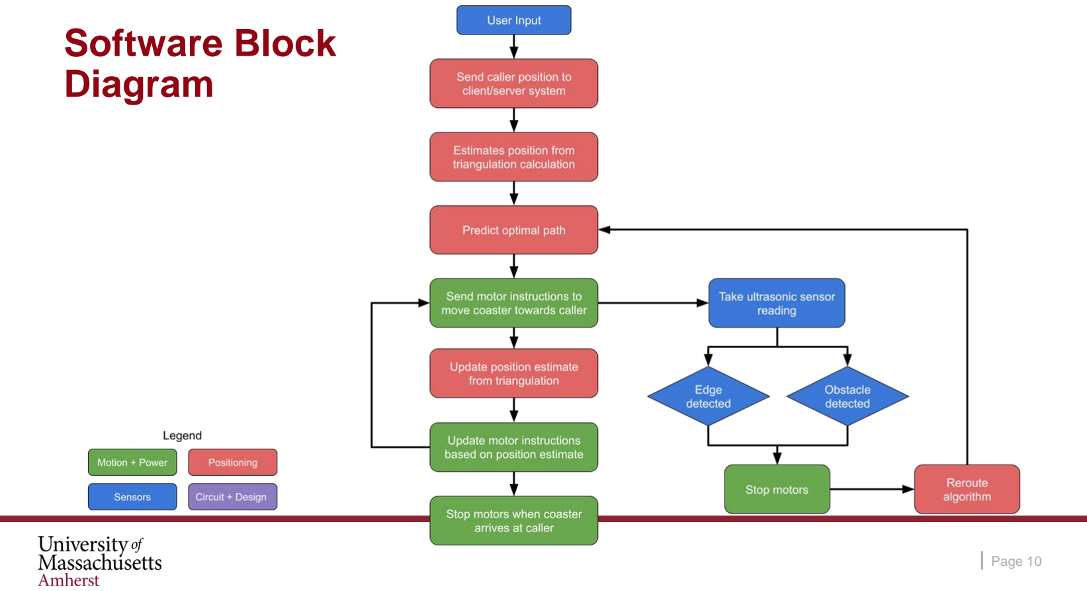
[picture p50: page 10]

# Subsystem: Motion

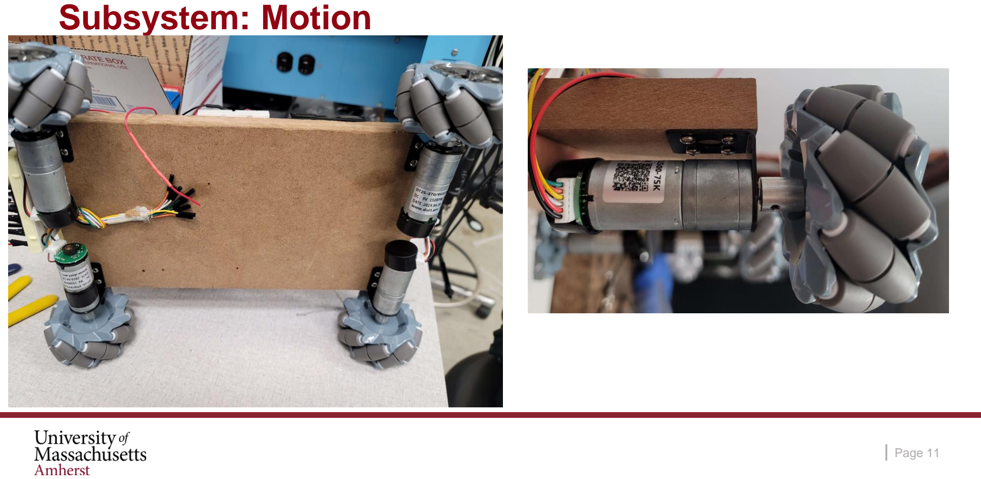
[picture p51: page 11]

# Motion: Circuit

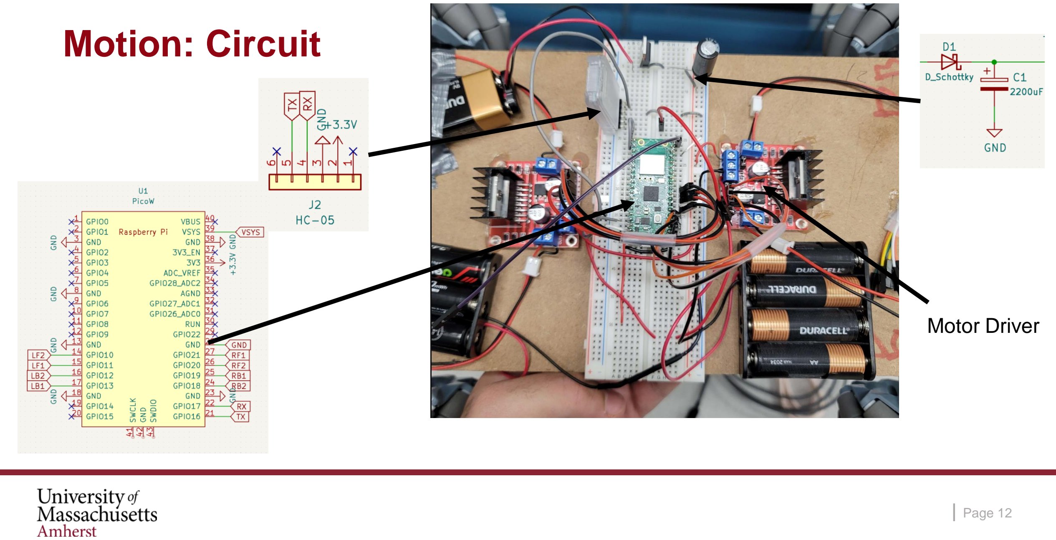
[picture p52: page 12]

Motor Driver

# Motion: PCB

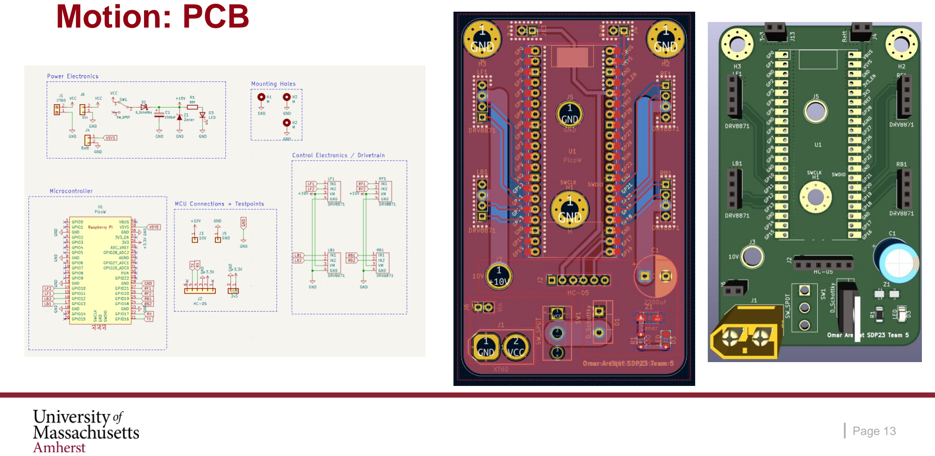
[picture p53: page 13]

# Motion: Debugging

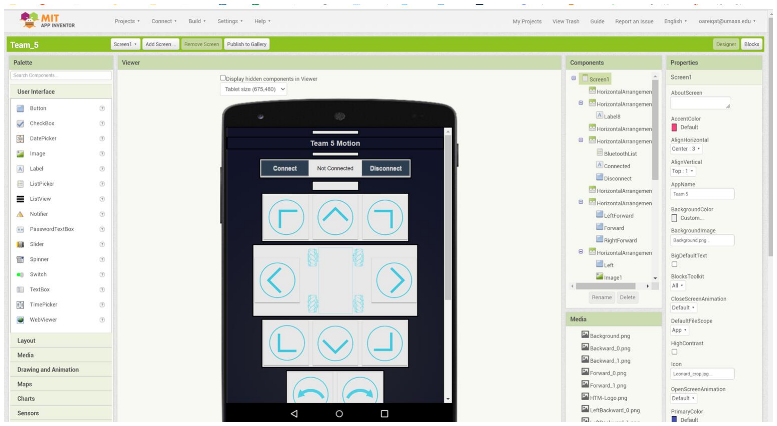
[picture p54: figure]

https://appinventor.mit.edu Page 14

# Motion: Debugging

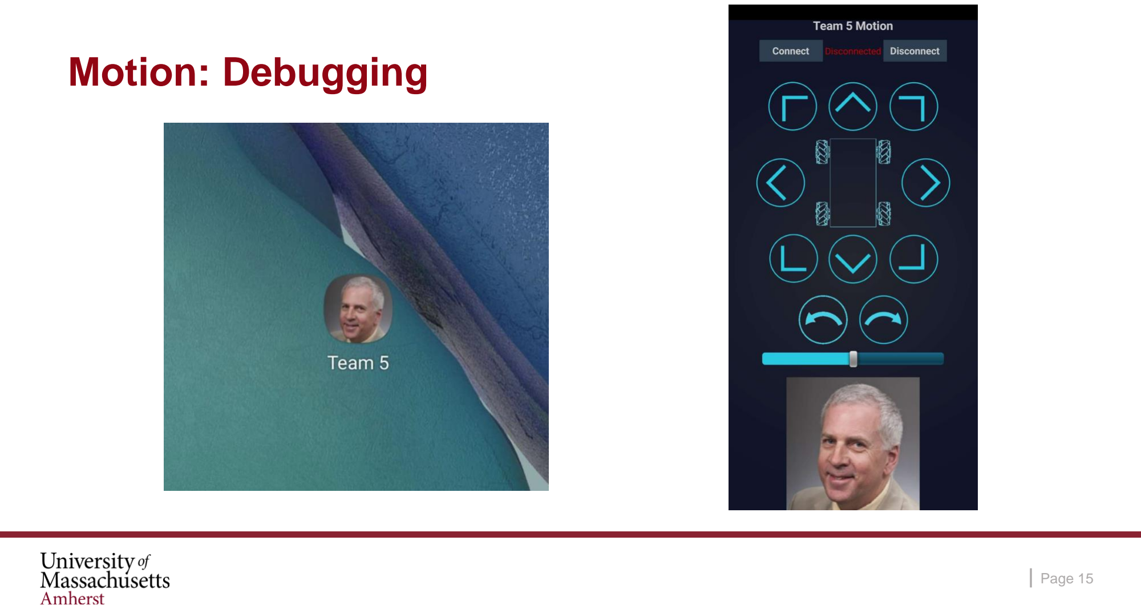
[picture p55: page 15]

# Subsystem: Power

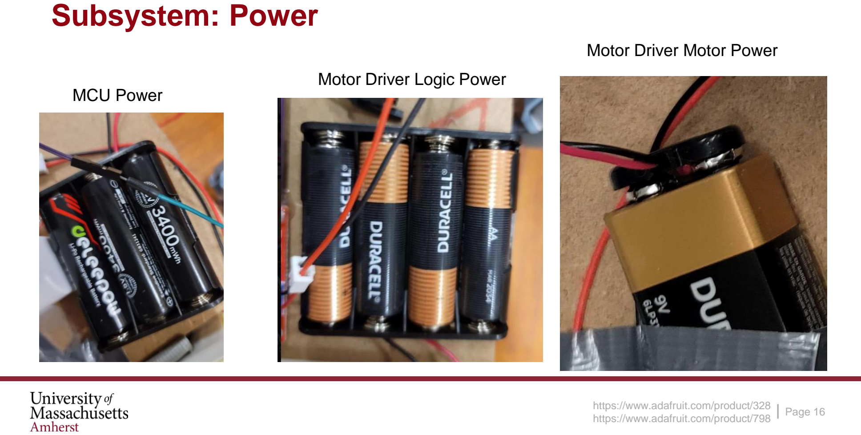
[picture p56: page 16]

Page 16 https://www.adafruit.com/product/328https://www.adafruit.com/product/798

MCU Power

Motor Driver Logic Power

Motor Driver Motor Power

# Subsystem: Positioning

## - Ultra Wideband Sensor

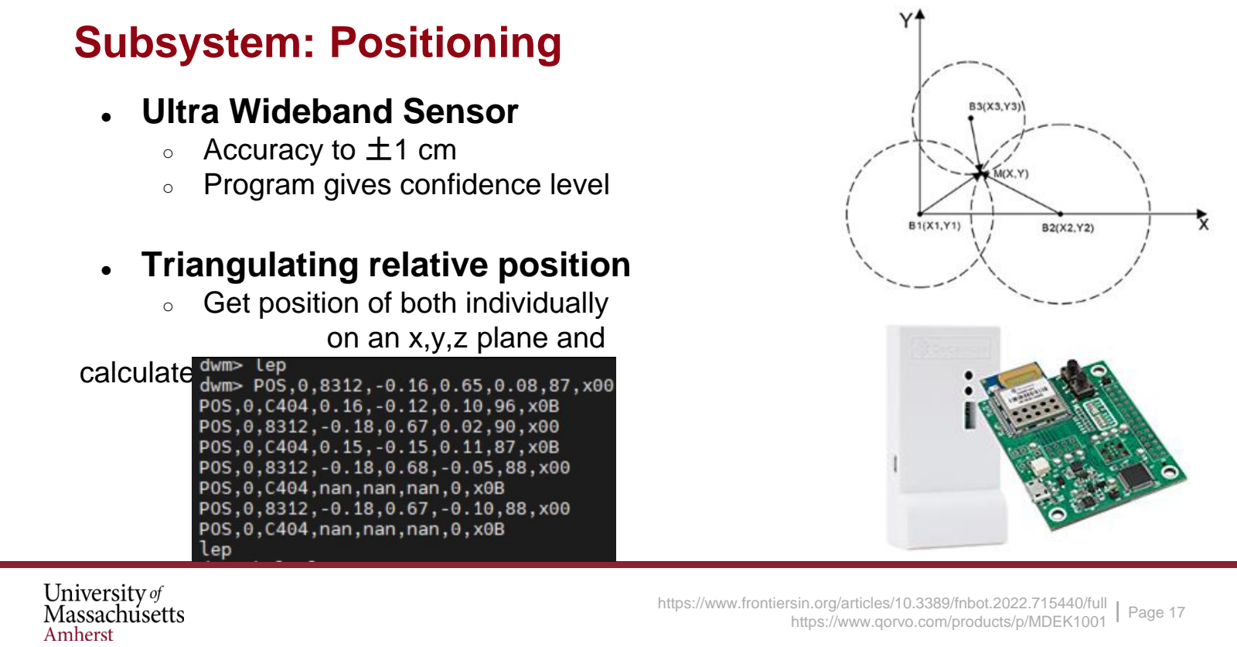
[picture p57: page 17]

https://www.frontiersin.org/articles/10.3389/fnbot.2022.715440/fullhttps://www.qorvo.com/products/p/MDEK1001 Page 17

## - Accuracy to 土1 cm - Program gives confidence level

## - Triangulating relative position

## - Get position of both individually on an x,y,z plane and calculate

# Subsystem: Collision and Cliff Detection

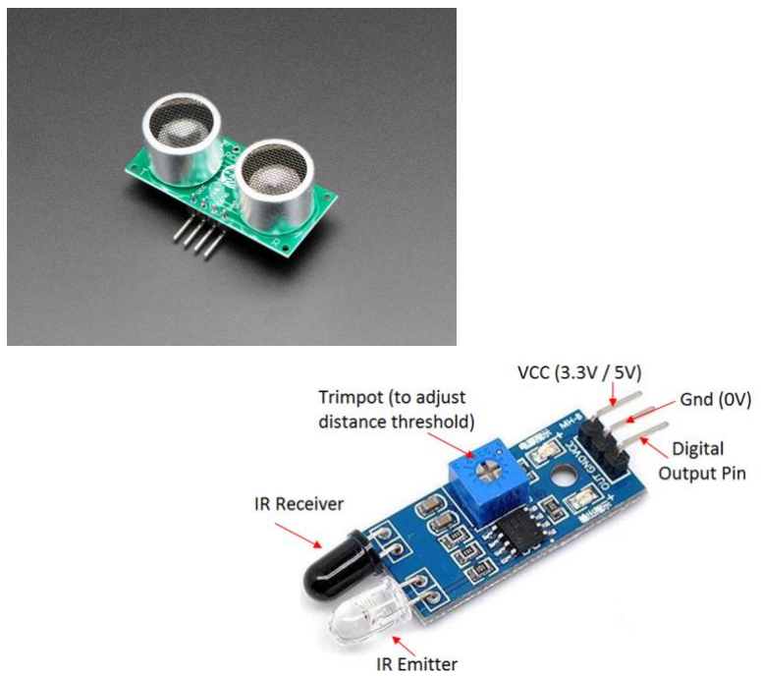
[picture p58: figure]

## - Ultrasonic

## - Edge detection - Clear path and obstacle detection

## - Infrared/Piezoelectric

## - Collision and impassable barrier detection

# Design: Chassis and PCB

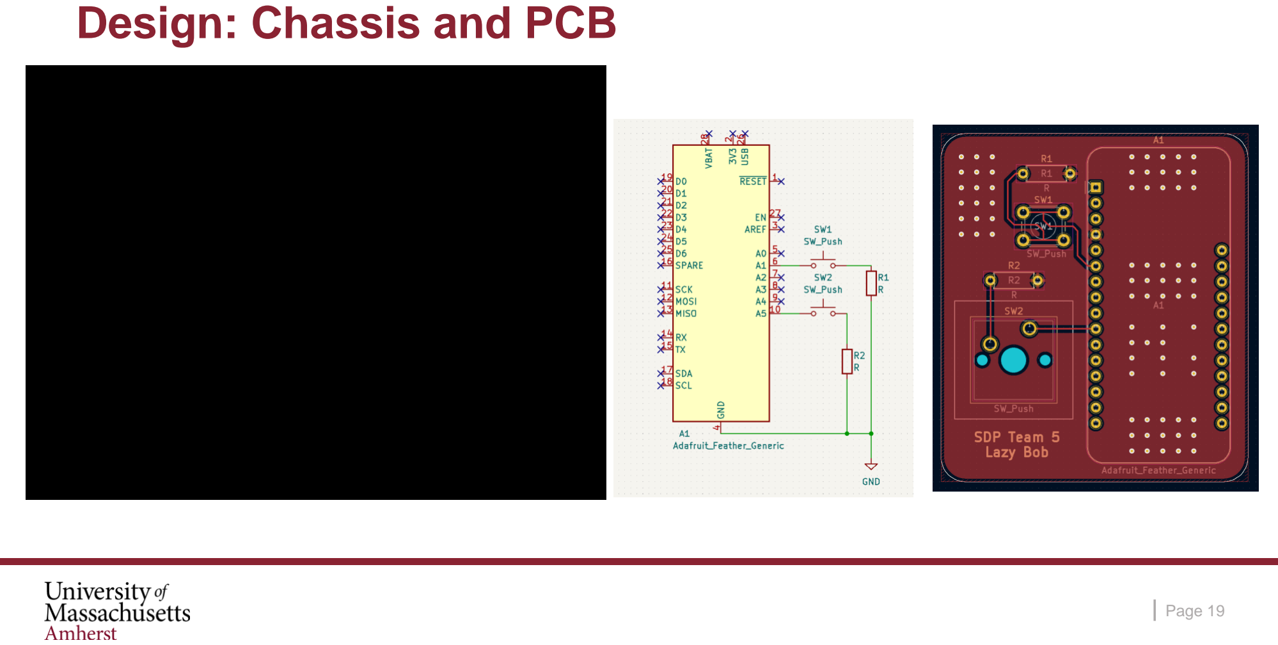
[picture p59: page 19]

# CDR Deliverables

## 1. “The Brains” and Live Data

## a. Instead of laptop, use Raspberry Pi or similar to process data

## a. Setup client/server system for inputs from multiple sources

## a. Continuously update position as coaster moves (Currently uses first set of coordinates to move)

## 2. Chassis for Coaster

## a. Circular body with a platform to put objects on

## b. Able to contain all components inside

## 3. PCB Plans

## a. Motion

## b. Sensors

## c. User input

# Next Semester Estimated Cost

Planned List
Item Name | Link | Price $ (with tax and shipping)
Raspberry Pi 4 | SDP | –0–
PCB | JLCPCB | 50.00
Sensors | M5 | 25.00
Motion PCB | Omar | –0–
4 x DRV8871 Motor Drivers | M5 | –0–
1s 1500mAh Lipo | M5 | –0–

216.95

# Total Expenses to-date

Total List
Item Name | Source | Price $ (with tax and shipping)
UWB DIY Starter Kit | Link (https://www.tindie.com/products/petteemfg/ultra-wideband-rtls-uwb-diy-starter-kit/) | 74.98
2 x Pico W | Wouter | 12.00
PCB1 | Wouter | 22.05
PCB | JLCPCB | 50.00
Sensors | M5 | 25.00
6 x Pico W | Wouter | 36.00
6 Dof Sensors | Amazon | 15.95
12 x RCR132a | Amazon | 40.00
Motors and Wheels | Digikey/Adafruit | 50.00

325.98

# Gantt Chart

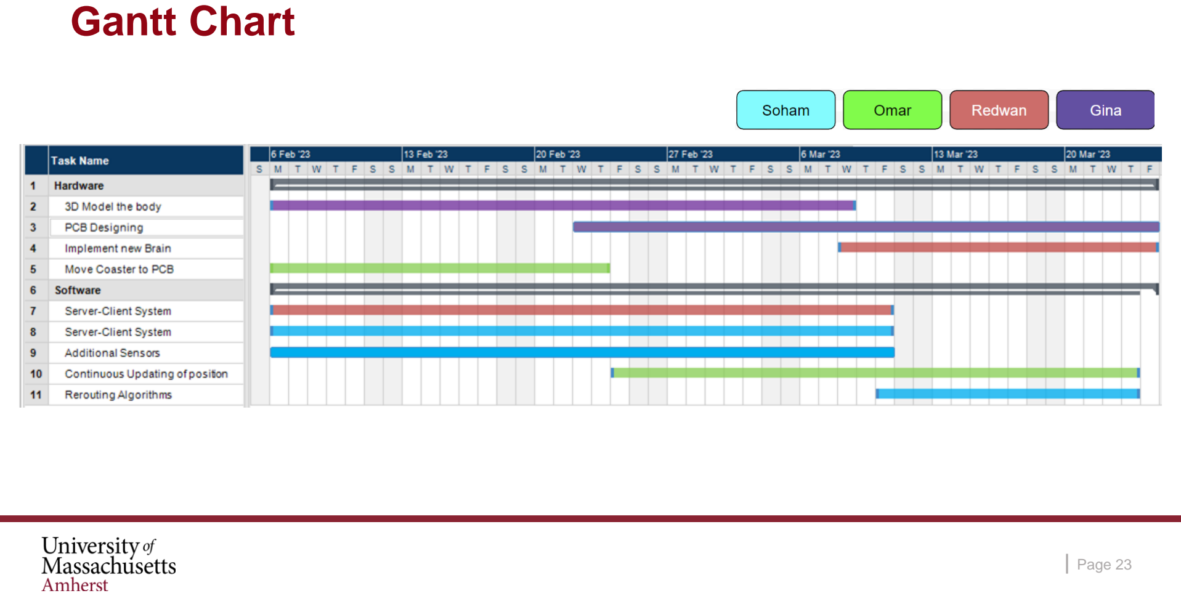
[picture p60: page 23]

# QUESTIONS & ANSWERS


# Video (if things go awry)

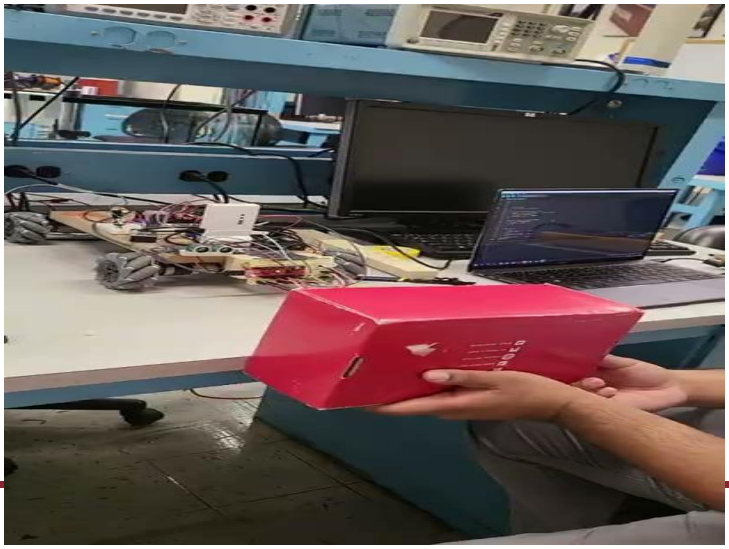
[picture p61: figure]
