OAreiqat/SDP23_Team5/SDP23_Team5_Website/assets/docs/PDR_Presentation.pdf

# PDR

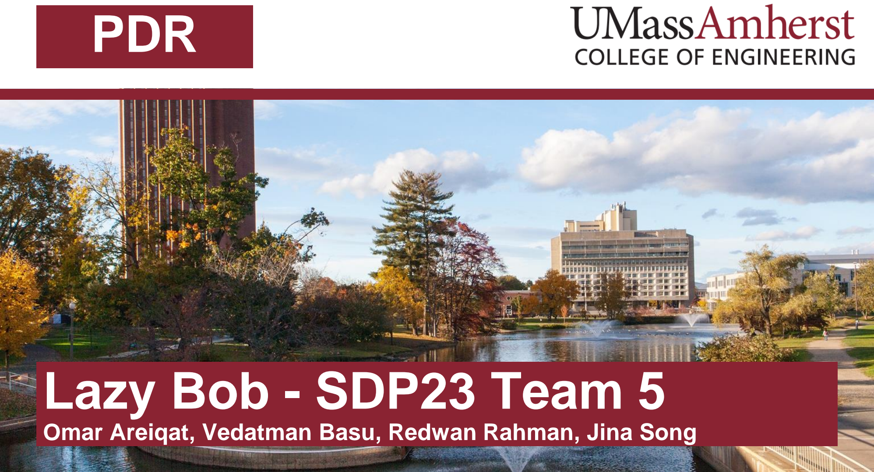
[picture p62: page 1]

# Lazy Bob - SDP23 Team 5

# Omar Areiqat, Vedatman Basu, Redwan Rahman, Jina Song


# The Team

## Omar Areiqat CompE Budget Lead Movement and Power

## Jina Song

EE

## PCB Lead Design

## Vedatman Soham Basu CompE Software Lead Sensors

## Redwan Rahman CompE Logistic Lead Positioning

## William Leonard Advisor

# Problem Statement


# Some people struggle with mundane actions in life, such as passing dishes on

a large table.

# Lazy Susans are nice, but only work on round tables and requires user to have

reach.

# What if there was a small, portable device that can move dishes across any table of arbitrary shape?

https://en.wikipedia.org/wiki/Lazy_Susan Page 3

# Our Solution

# “Lazy Bob”: A moving coaster that approaches the user when

called.

# 1. Stably transport items around a table to different users

# 1. Provide a simple way to interface with all coasters

# 1. Adapt to its environment

## Plate 2

## Purple: Caller

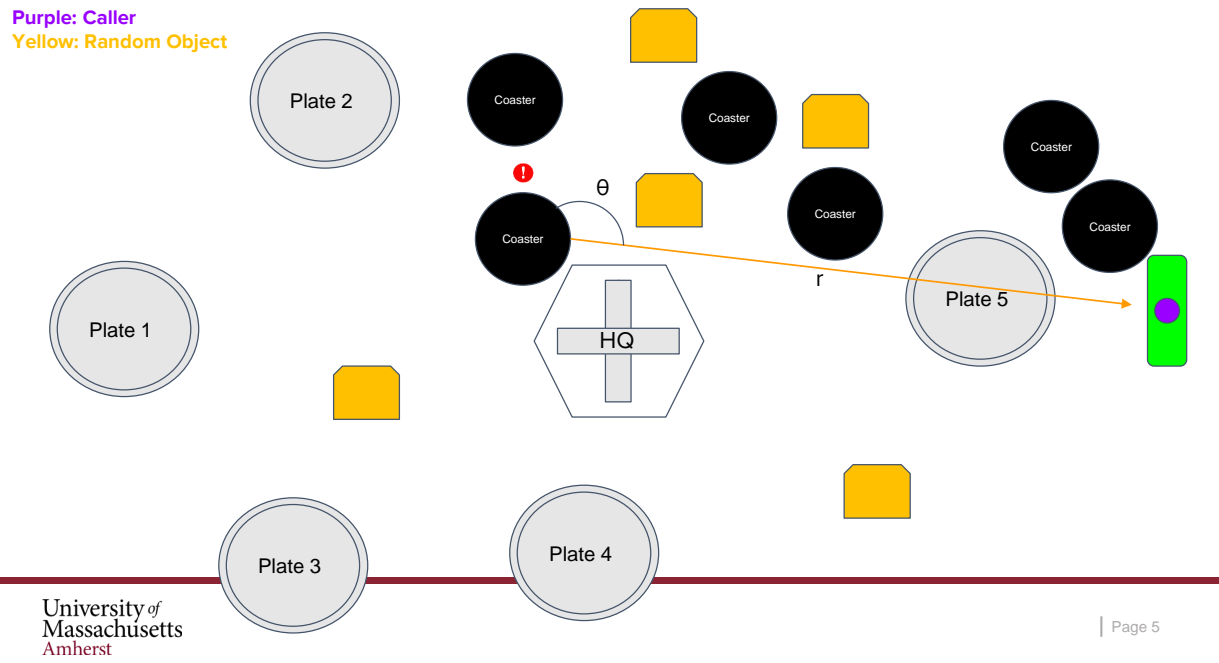
[picture p63: page 5]
Coaster; Plate 5; Plate 3; Plate 1; Plate 4

Yellow: Random Object

# Similar Product: AirPorter

# - Autonomous-driving capability that

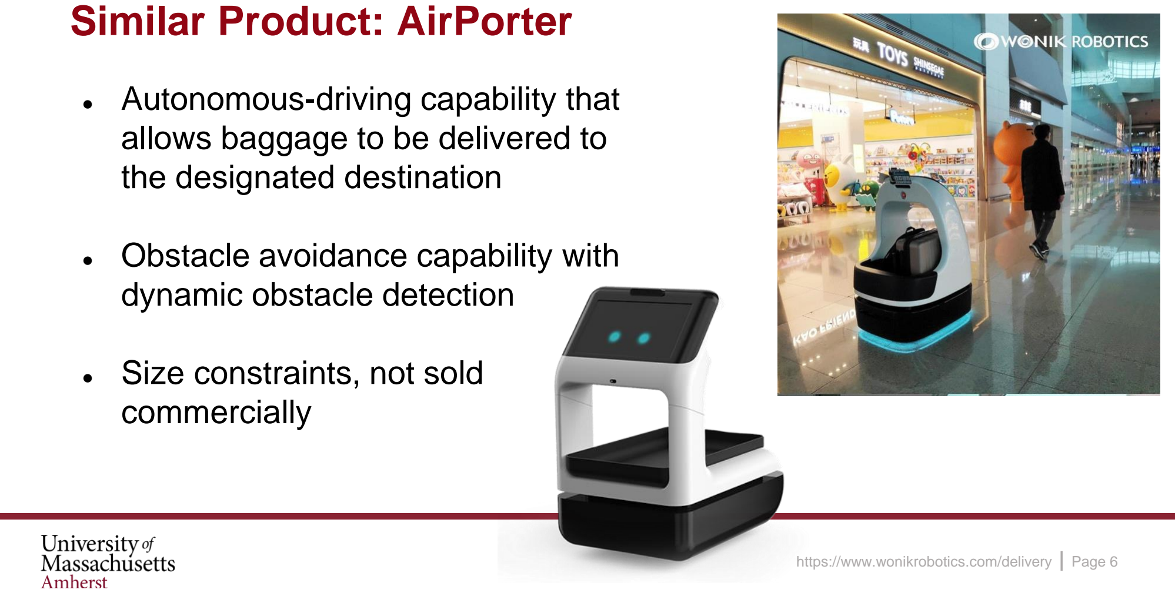
[picture p64: page 6]

# allows baggage to be delivered to the designated destination

# - Obstacle avoidance capability with dynamic obstacle detection

# - Size constraints, not sold commercially

https://www.wonikrobotics.com/delivery Page 6

# Similar Product: Starship Delivery Robot

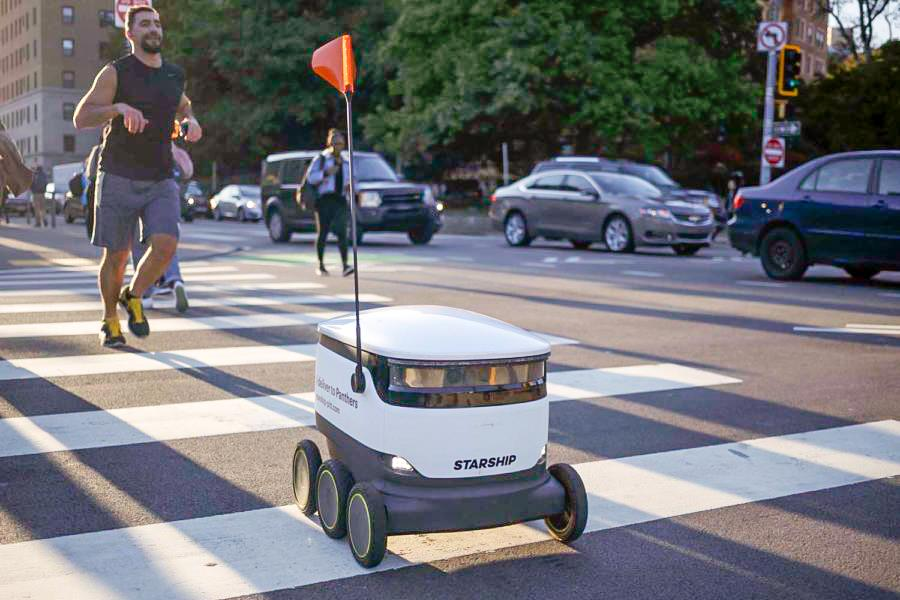
[picture p65: figure]

# - An autonomous device that carries items over short distances

# - Uses twelve cameras, ultrasonic

sensors, radar, neural networks,

# etc. to detect obstacles

# - Uses computer vision and GPS for location

https://pittnews.com/article/160259/news/starship-robots-may-return-in-future-under-new-dining-contractor/ Page 7

# Similar Product: Robot Vacuums

# - Collision avoidance

# - Cliff detection

- They use image processing,

# sensors

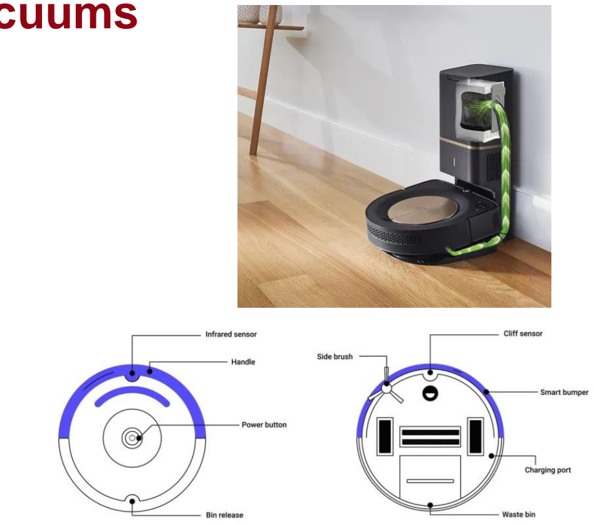
[picture p66: figure]

https://www.irobot.com/en_US/roomba-vacuuming/robot-vacuum-irobot-roomba-s9-plus/S955020.htmlhttps://www.thezebra.com/resources/home/how-roomba-works/ Page 8

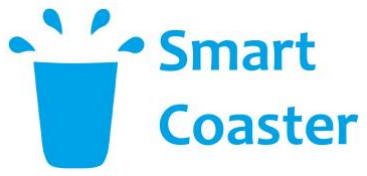
[picture p67: figure]

# Similar Product: Smart Coaster

# (SDP 20 Team 16)

# - A wireless coaster system that

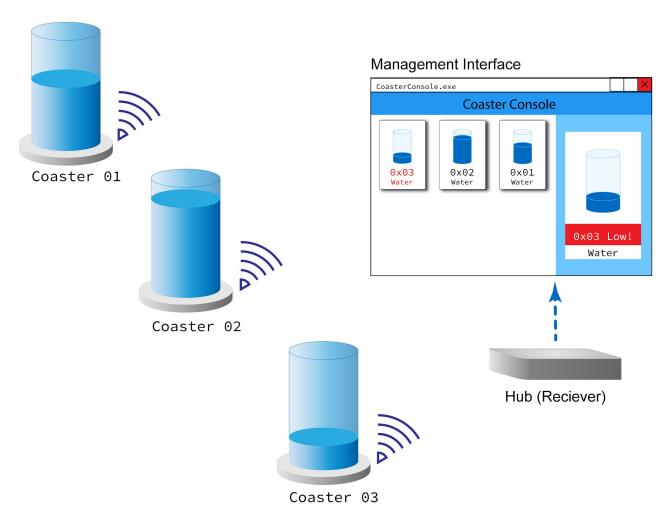
[picture p68: figure]

# notifies wait staff when a customer's drink is almost empty

- Similarities: Wireless communication,

# rechargeable batteries

# - Differences: Inanimate, different purpose

http://www.ecs.umass.edu/ece/sdp/sdp20/team16/ Page 9

# Similar Product: Comparison

| Movement | Transport | Rechargeable | Avoid obstacles | Avoid cliff | Size | Call to location | Cost
AirPorter | | | | | | | | N/A
Starship | | | | | | | | N/A

## Robot Vacuums

Smart Coaster | | | | | | | | N/A

## Lazy Bob

# System Specifications: Functional

# 1. Accelerate at a rate of 0.5 cm/s² towards the caller, up to 7 cm/s

# 1. Transport items without the items falling off

# 1. Detect the edges of the table and avoid falling off

# 1. Avoid objects in its path and arrive at its destination

1. Support up to 3 lbs.

# Test Plan 1. Use a tape measure to check the distance travelled every second

# 1. Put objects on moving coaster and watch if object falls

# 1. Watch if it falls off when caller is away from the table

# 1. Put objects in path and check if it bumps into object

# 1. Place an object that weighs 3 lbs and check if system is stable while moving

# System Specifications: Design

# Test Plan 5. Watch it move towards hub on a given signal

# 6. Call both coasters on a collision course and see if they collide

# 7. Use tape measure

# 8. Find and put on irregular shaped tables and check if they fall off

# 9. Line up objects to allow no path to caller, see if system notifies caller

# 5. Move back to its hub once determined not in use

# 6. System supports at least 2 coasters at the same time

# 7. Coaster diameter is within 25 cm

# 8. Be able to use it regardless of table shape

9. If no path to caller is available,

# indicate to caller

# Hardware Block Diagram

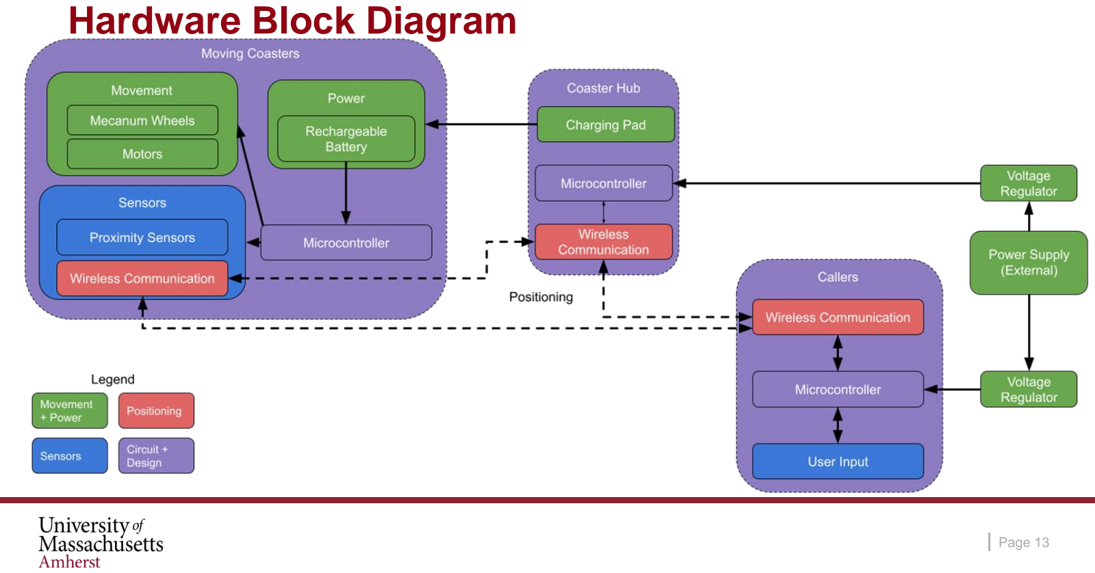
[picture p69: page 13]

# Software Block Diagram

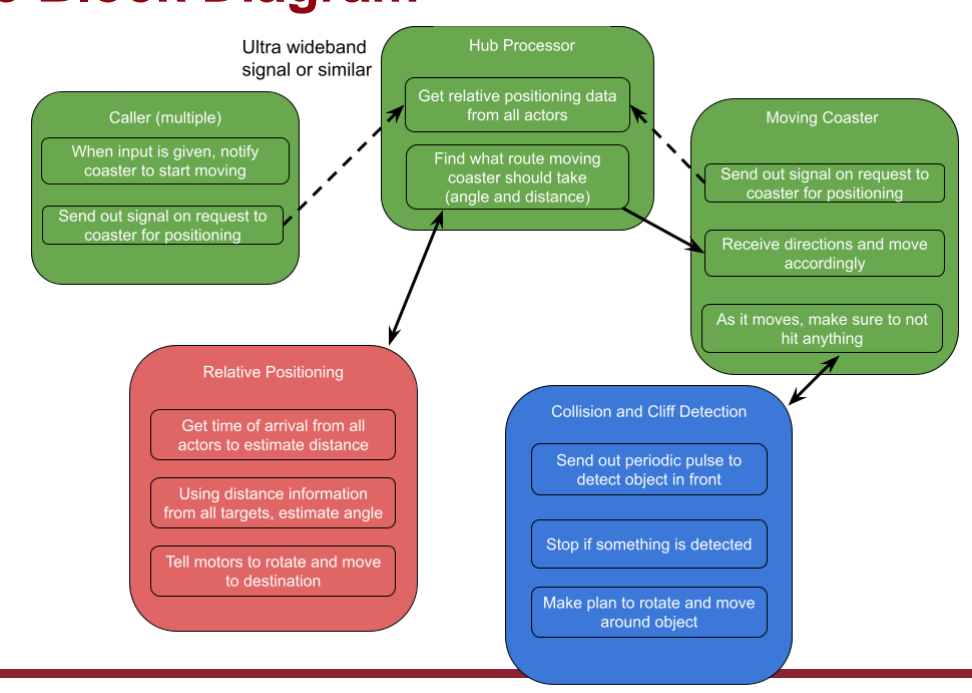
[picture p70: figure]

# Subsystem: Motion

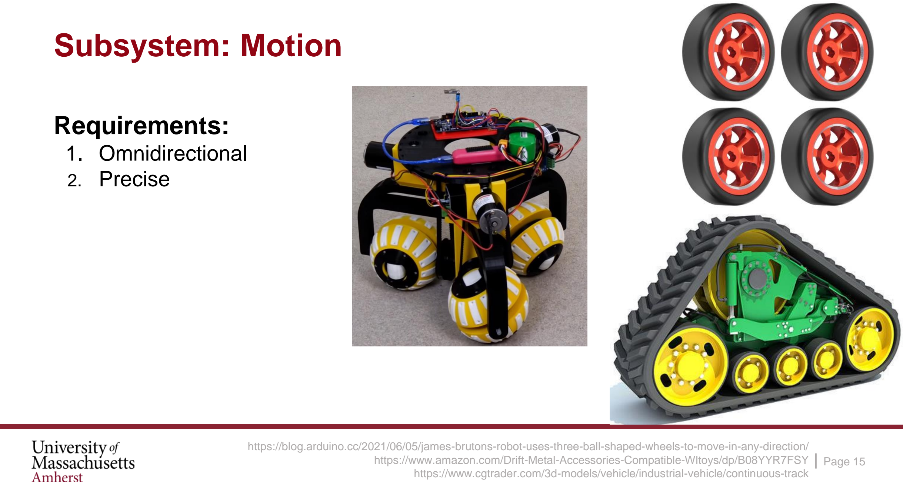
[picture p71: page 15]

# Requirements:

# 1. Omnidirectional 2. Precise

https://blog.arduino.cc/2021/06/05/james-brutons-robot-uses-three-ball-shaped-wheels-to-move-in-any-direction/https://www.amazon.com/Drift-Metal-Accessories-Compatib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

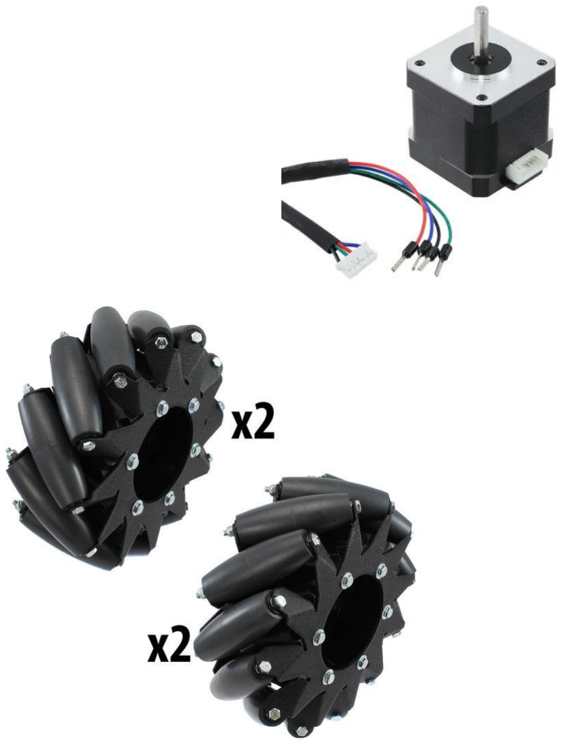
[picture p72: figure]

# Subsystem: Motion

# Requirements:

# 1. Omnidirectional 2. Precise

# Plan:

# 1. Motor: 4x Stepper Motors 2. Wheels: 4x Mecanum Wheels

Page 16 https://www.andymark.com/products/10-in-mecanum-wheel-set-steel-body-6-hole-borehttps://www.digikey.com/en/products/detail/dfrobot/FIT0278/6588458

# Subsystem: Motion

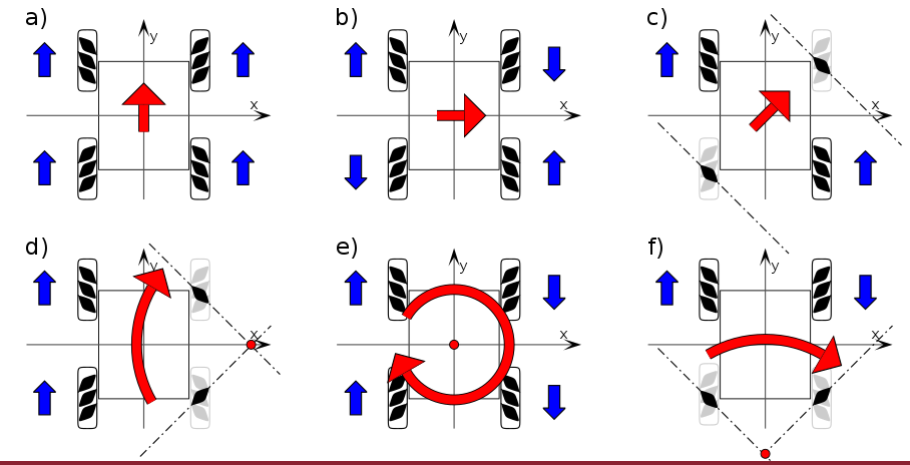
[picture p73: figure]

https://en.wikipedia.org/wiki/Mecanum_wheel Page 17

# Subsystem: Motion

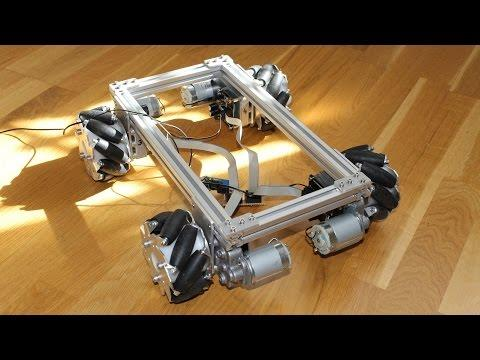
[picture p74: figure]

https://youtu.be/Ne09Y72zW_Y Page 18

# Subsystem: Power

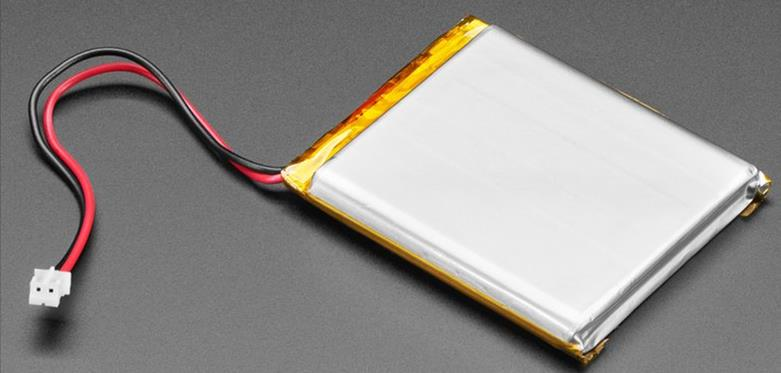
[picture p75: figure]

# - Lithium-ion batteries

Page 19 https://www.adafruit.com/product/328https://www.adafruit.com/product/798

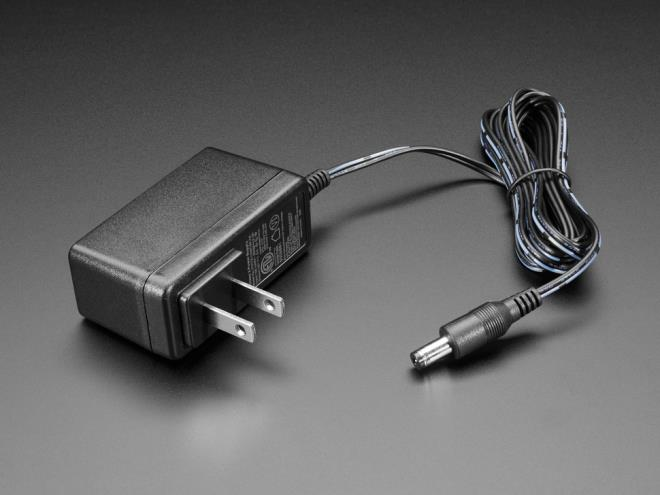
[picture p76: figure]

# Subsystem: Charging

# - Connection

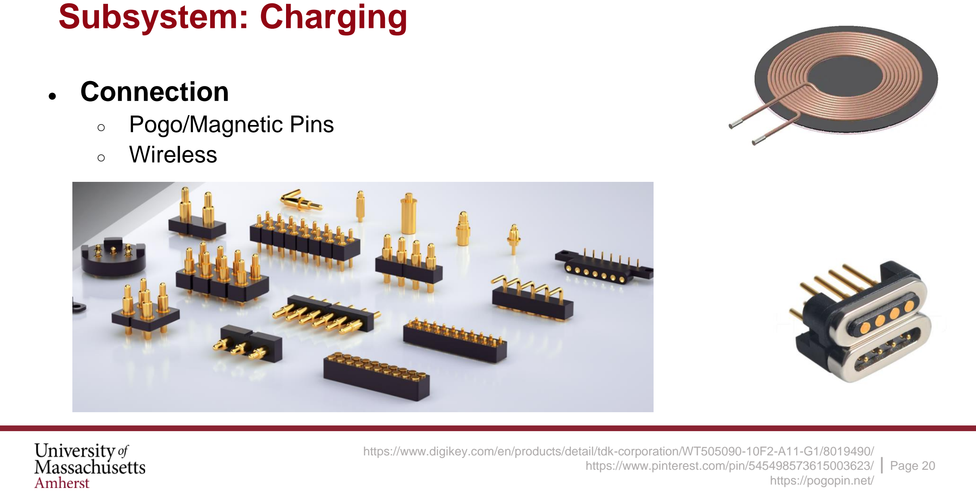
[picture p77: page 20]

# - Pogo/Magnetic Pins - Wireless

https://www.digikey.com/en/products/detail/tdk-corporation/WT505090-10F2-A11-G1/8019490/https://www.pinterest.com/pin/545498573615003623/https://pogopin.net/

# Subsystem: Relative Positioning

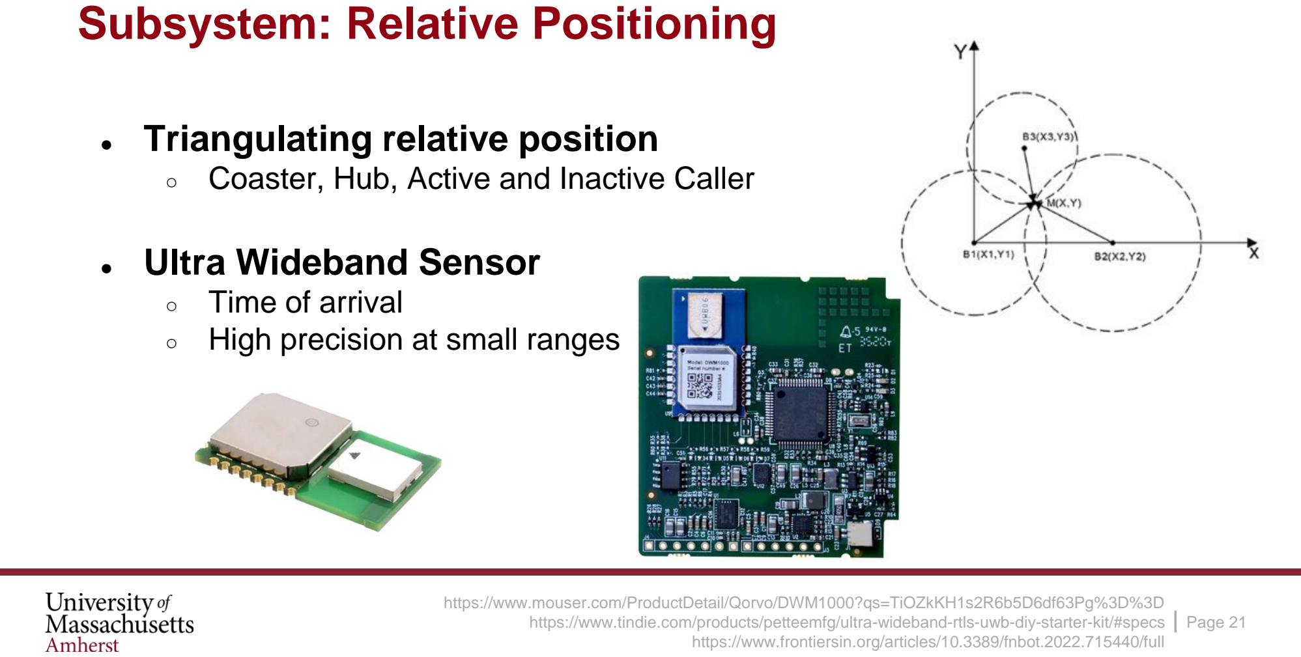
[picture p78: page 21]

# - Triangulating relative position

# - Coaster, Hub, Active and Inactive Caller

# - Ultra Wideband Sensor

# - Time of arrival - High precision at small ranges

https://www.mouser.com/ProductDetail/Qorvo/DWM1000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

# Subsystem: Collision and Cliff Detection

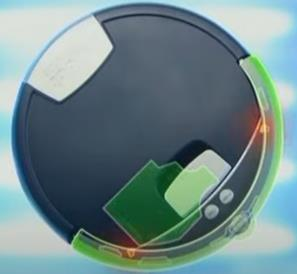
[picture p79: figure]

# - Piezoelectric

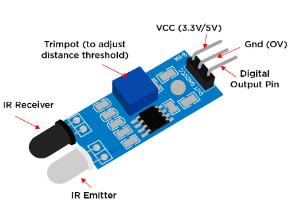
[picture p80: figure]

# - Calibration

# - Ultrasonic

# - Distance measurement

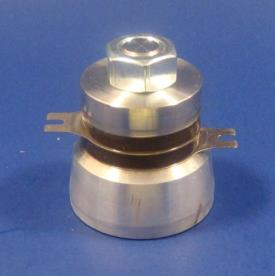
[picture p81: figure]
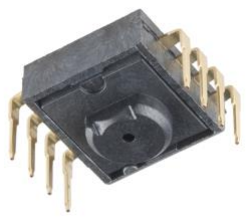
[picture p82: figure]

# - Photocell/Infrared

# - Cliff Detection & Collision Detection

# - Stretch Goal: Optic Sensors

# - Mapping

https://www.youngwonks.com/blog/What-is-an-infrared-sensorhttps://www.americanpiezo.com/piezo-theory/whats-a-transducer.htmlhttps://www.sparkfun.com/products/retired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

# Estimated Cost

Item | Quantity | Price per | Total
MCU | 6 | $ 8.00 | $ 48.00
UWB sensor | 6 | $ 17.00 | $ 102.00
PCB | 4 | $ 25.00 | $ 100.00
Motors | 10 | $ 7.60 | $ 76.00
Wheels | 9 | $ 4.50 | $ 40.50
Battery and Charging | 3 | $ 15.00 | $ 45.00
Collision Sensors | 5 | $ 7.15 | $ 35.75
Cliff Detection Sensor | 3 | $ 5.00 | $ 15.00
Input Device | 6 | Owned | $ 0.00
Total | | | $ 462.25

# MDR Deliverables

# - 1 Moving Coaster

# - Moves properly and accurately - Accurately detects positioning - Goes to location when called - Can detect if an object is in the way

# - 2 Callers

# - Can send signal to coaster and hub

# - 1 Charging Hub

# - Can send signal to coaster and callers - Potentially charges system

# - Plans for PCB

# - Motor Pins - Microcontroller

■ | Sensors
■ | Communication
■ | User input method

# Gantt Chart

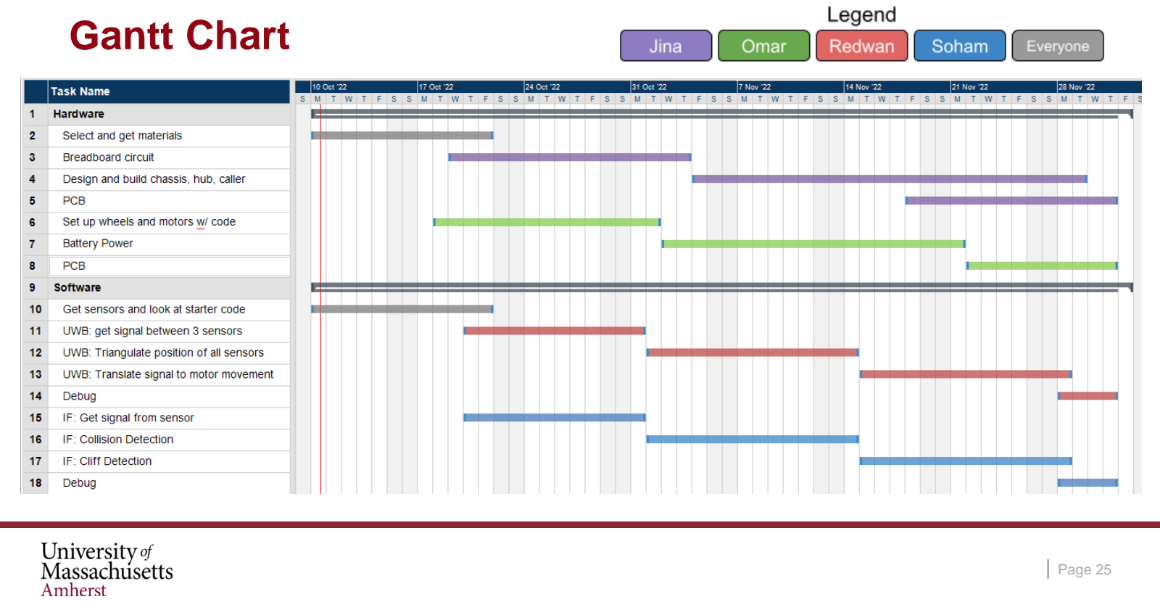
[picture p83: page 25]

# QUESTIONS & ANSWERS
