OAreiqat/SDP23_Team5/SDP23_Team5_Website/assets/img/bg4.png

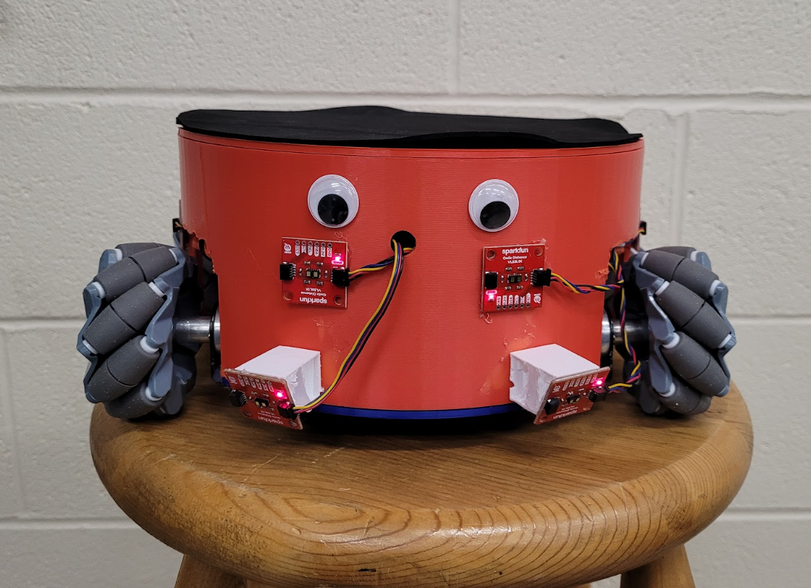
SDP23_Team5_Website/assets/img/bg4.png
