OAreiqat/SDP23_Team5/SDP23_Team5_Website/assets/img/Team Members/Baird.jpg

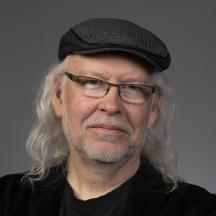
SDP23_Team5_Website/assets/img/Team Members/Baird.jpg
