OAreiqat/SDP23_Team5/SDP23_Team5_Website/assets/img/Team Members/Kris.jpg

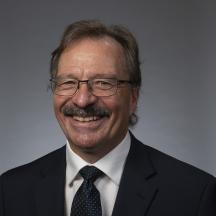
SDP23_Team5_Website/assets/img/Team Members/Kris.jpg
