OAreiqat/SDP23_Team5/SDP23_Team5_Website/assets/img/Team Members/omar216.png

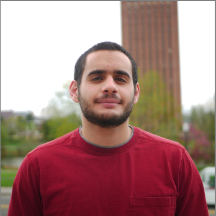
SDP23_Team5_Website/assets/img/Team Members/omar216.png
