OAreiqat/SDP23_Team5/Coaster_PCB_CDR/Coaster_PCB_CDR.kicad_pcb

## KiCad design Coaster_PCB_CDR/Coaster_PCB_CDR.kicad_pcb (2023-04-25)

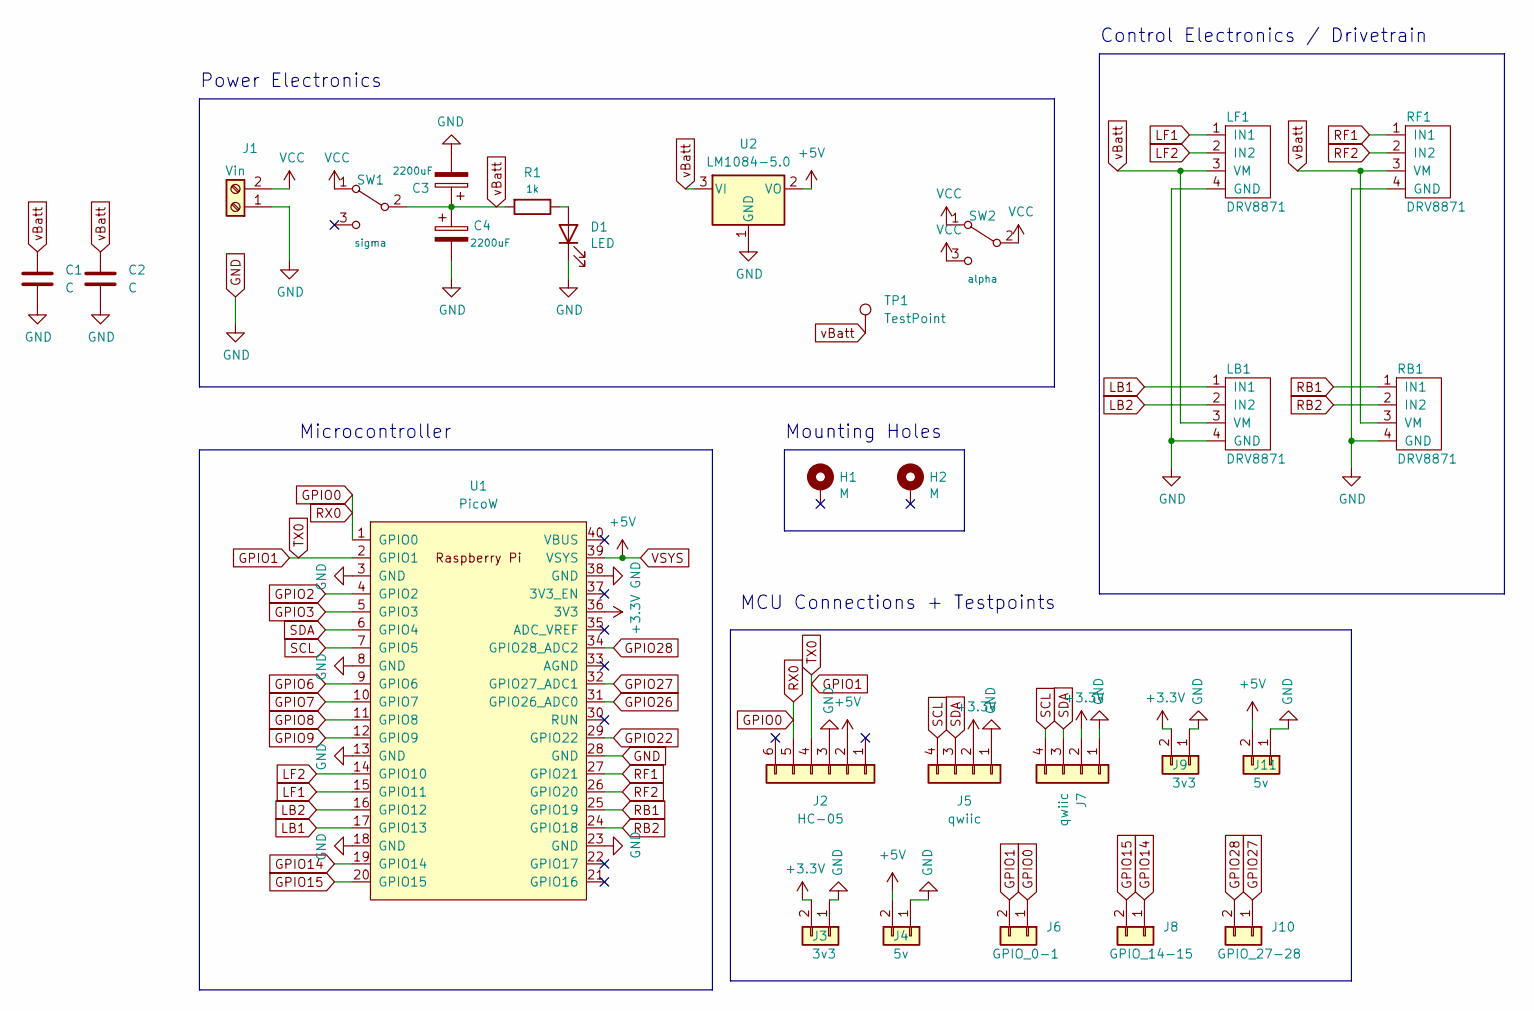
[picture p95: schematic Coaster_PCB_CDR.kicad_sch, SDP23_Team5_Coaster]

Parts:
C1, C2: C; C_Disc_D3.0mm_W1.6mm_P2.50mm
C3, C4: 2200uF; CP_Radial_D10.0mm_P5.00mm
D1: LED; LED_D3.0mm
H1, H2: M; MountingHole_4.3mm_M4_Pad_Via
J1: Vin; AMASS_XT60-M_1x02_P7.20mm_Vertical
J2: HC-05; PinSocket_1x06_P2.54mm_Vertical
J3, J9: 3v3; PinSocket_1x02_P2.54mm_Vertical
J4, J11: 5v; PinSocket_1x02_P2.54mm_Vertical
J5: qwiic; PinSocket_1x04_P2.54mm_Vertical
J6: GPIO_0-1; PinSocket_1x02_P2.54mm_Vertical
J7: qwiic; JST_SH_SM04B-SRSS-TB_1x04-1MP_P1.00mm_Horizontal
J8: GPIO_14-15; PinSocket_1x02_P2.54mm_Vertical
J10: GPIO_27-28; PinSocket_1x02_P2.54mm_Vertical
LB1: DRV8871; PinSocket_1x04_P2.54mm_Vertical
LF1: DRV8871; PinSocket_1x04_P2.54mm_Vertical
R1: 1k; R_Axial_DIN0207_L6.3mm_D2.5mm_P10.16mm_Horizontal
RB1: DRV8871; PinSocket_1x04_P2.54mm_Vertical
RF1: DRV8871; PinSocket_1x04_P2.54mm_Vertical
SW1: sigma; omar_3pin_switch
SW2: alpha; omar_3pin_switch
TP1: TestPoint; TestPoint_THTPad_D1.5mm_Drill0.7mm
U1: PicoW; RPi_PicoW_SMD_TH
U2: LM1084-5.0; TO-220-3_Vertical

Connections:
+3V3: J3.2, J5.2, J7.2, J9.2, U1.36 (3V3)
GND: C1.2, C2.2, C3.2, C4.2, D1.1 (K), J1.1, J2.3, J3.1, J4.1, J5.1, J7.1, J9.1, J11.1, LB1.4 (GND), LF1.4 (GND), RB1.4 (GND), RF1.4 (GND), U1.3 (GND), U1.8 (GND), U1.13 (GND), U1.18 (GND), U1.23 (GND), U1.28 (GND), U1.38 (GND), U2.1 (GND)
GPIO0: J2.5, J6.1, U1.1 (GPIO0)
GPIO1: J2.4, J6.2, U1.2 (GPIO1)
GPIO2: U1.4 (GPIO2)
GPIO3: U1.5 (GPIO3)
GPIO6: U1.9 (GPIO6)
GPIO7: U1.10 (GPIO7)
GPIO8: U1.11 (GPIO8)
GPIO9: U1.12 (GPIO9)
GPIO14: J8.1, U1.19 (GPIO14)
GPIO15: J8.2, U1.20 (GPIO15)
GPIO22: U1.29 (GPIO22)
GPIO26: U1.31 (GPIO26_ADC0)
GPIO27: J10.1, U1.32 (GPIO27_ADC1)
GPIO28: J10.2, U1.34 (GPIO28_ADC2)
LB1: LB1.1 (IN1), U1.17 (GPIO13)
LB2: LB1.2 (IN2), U1.16 (GPIO12)
LF1: LF1.1 (IN1), U1.15 (GPIO11)
LF2: LF1.2 (IN2), U1.14 (GPIO10)
unnamed: D1.2 (A), R1.1
RB1: RB1.1 (IN1), U1.25 (GPIO19)
RB2: RB1.2 (IN2), U1.24 (GPIO18)
RF1: RF1.1 (IN1), U1.27 (GPIO21)
RF2: RF1.2 (IN2), U1.26 (GPIO20)
SCL: J5.4, J7.4, U1.7 (GPIO5)
SDA: J5.3, J7.3, U1.6 (GPIO4)
VCC: J1.2, SW1.1 (A), SW2.1 (A), SW2.2 (B), SW2.3 (C)
VSYS: J2.2, J4.2, J11.2, U1.39 (VSYS), U2.2 (VO)
vBatt: C1.1, C2.1, C3.1, C4.1, LB1.3 (VM), LF1.3 (VM), R1.2, RB1.3 (VM), RF1.3 (VM), SW1.2 (B), TP1.1, U2.3 (VI)

Notes on the sheet:
MCU Connections + Testpoints
Control Electronics / Drivetrain
Power Electronics
Mounting Holes
Microcontroller

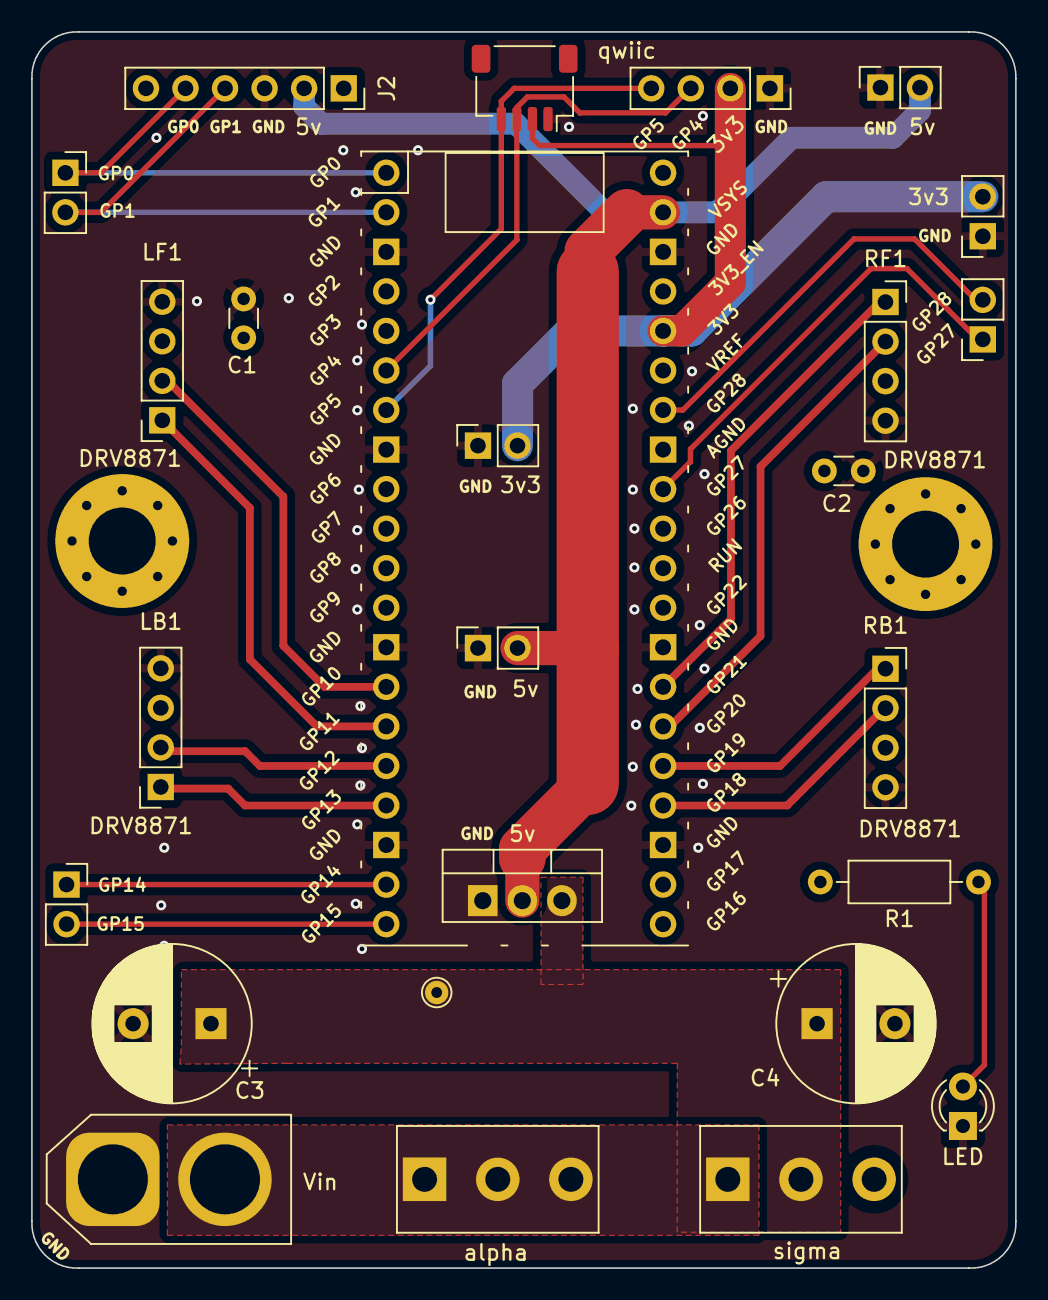
[picture p96: board Coaster_PCB_CDR.kicad_pcb from above]

Board: 2 copper layers, 63.2 x 79.4 mm, 28 parts (0 on the bottom side), 22 nets.
