OAreiqat/SDP23_Team5/(commit log)

2022-12-03 Removed old gerber
    [Team5_Coaster-B_Cu.gbr, Team5_Coaster-B_Mask.gbr, Team5_Coaster-B_Paste.gbr, Team5_Coaster-B_Silkscreen.gbr, Team5_Coaster-Edge_Cuts.gbr, Team5_Coaster-F_Cu.gbr, Team5_Coaster-F_Mask.gbr, Team5_Coaster-F_Paste.gbr]
2022-12-03 Moved files to folder
    [Team5_Coaster.kicad_pcb, Team5_Coaster.kicad_sch]
2022-12-05 Minor PCB change
    [Team5_Coaster.kicad_pcb]
2022-12-09 Post MDR
    Python Scripts Debugged. PCB slight changes
    [Team5_Coaster.kicad_pcb, Team5_Coaster.kicad_sch]
2022-12-10 New PCB folder CDR or FDR
    [Team5_Coaster_post_mdr.kicad_pcb, Team5_Coaster_post_mdr.kicad_sch]
2022-12-10 Created output gerber files for max speed coaster pcb
    [Team5_Coaster-B_Cu.gbr, Team5_Coaster-B_Mask.gbr, Team5_Coaster-B_Paste.gbr, Team5_Coaster-B_Silkscreen.gbr, Team5_Coaster-Edge_Cuts.gbr, Team5_Coaster-F_Cu.gbr, Team5_Coaster-F_Mask.gbr, Team5_Coaster-F_Paste.gbr]
2022-12-13 Working on CDR Motion PCB
    [Team5_Coaster.kicad_pcb, Team5_Coaster_post_mdr.kicad_pcb, Team5_Coaster_post_mdr.kicad_sch]
2022-12-13 PCB Read for export, DRC passes
    [Team5_Coaster_post_mdr.kicad_pcb, Team5_Coaster_post_mdr.kicad_sch]
2022-12-13 Updated Pico Symbol, add some silk screen for gpio
    [Team5_Coaster_post_mdr.kicad_pcb, Team5_Coaster_post_mdr.kicad_sch]
2022-12-13 Exported Gerbers for new PCB
    [Team5_Coaster-B_Cu.gbr, Team5_Coaster-B_Mask.gbr, Team5_Coaster-B_Silkscreen.gbr, Team5_Coaster-Edge_Cuts.gbr, Team5_Coaster-F_Cu.gbr, Team5_Coaster-F_Mask.gbr, Team5_Coaster-F_Paste.gbr, Team5_Coaster-F_Silkscreen.gbr]
2022-12-13 Added 100x100 version of pcb
    [Team5_Coaster_post_mdr-B_Cu.gbr, Team5_Coaster_post_mdr-B_Mask.gbr, Team5_Coaster_post_mdr-B_Paste.gbr, Team5_Coaster_post_mdr-B_Silkscreen.gbr, Team5_Coaster_post_mdr-Edge_Cuts.gbr, Team5_Coaster_post_mdr-F_Cu.gbr, Team5_Coaster_post_mdr-F_Paste.gbr, Team5_Coaster_post_mdr-F_Silkscreen.gbr]
2022-12-13 Added power zone
    [Team5_Coaster_post_mdr_100x100.kicad_pcb, Team5_Coaster_post_mdr_100x100.kicad_sch]
2022-12-13 Further updated power traces/zones on 100x100 pcb
    [Team5_Coaster_post_mdr_100x100-B_Cu.gbr, Team5_Coaster_post_mdr_100x100-B_Mask.gbr, Team5_Coaster_post_mdr_100x100-B_Paste.gbr, Team5_Coaster_post_mdr_100x100-B_Silkscreen.gbr, Team5_Coaster_post_mdr_100x100-Edge_Cuts.gbr, Team5_Coaster_post_mdr_100x100-F_Cu.gbr, Team5_Coaster_post_mdr_100x100-F_Mask.gbr, Team5_Coaster_post_mdr_100x100-F_Paste.gbr]
2022-12-13 did board auto cleanup
    [Team5_Coaster_post_mdr_100x100-B_Cu.gbr, Team5_Coaster_post_mdr_100x100-B_Mask.gbr, Team5_Coaster_post_mdr_100x100-B_Paste.gbr, Team5_Coaster_post_mdr_100x100-B_Silkscreen.gbr, Team5_Coaster_post_mdr_100x100-Edge_Cuts.gbr, Team5_Coaster_post_mdr_100x100-F_Cu.gbr, Team5_Coaster_post_mdr_100x100-F_Mask.gbr, Team5_Coaster_post_mdr_100x100-F_Paste.gbr]
2022-12-13 Updated Directories, 100x100 is now Coaster_PCB_CDR
    [Coaster_PCB_CDR-B_Cu.gbr, Coaster_PCB_CDR-B_Mask.gbr, Coaster_PCB_CDR-B_Paste.gbr, Coaster_PCB_CDR-B_Silkscreen.gbr, Coaster_PCB_CDR-Edge_Cuts.gbr, Coaster_PCB_CDR-F_Cu.gbr, Coaster_PCB_CDR-F_Mask.gbr, Coaster_PCB_CDR-F_Paste.gbr]
2022-12-13 Updated CDR PCB more
    [Coaster_PCB_CDR-B_Cu.gbr, Coaster_PCB_CDR-B_Mask.gbr, Coaster_PCB_CDR-B_Paste.gbr, Coaster_PCB_CDR-B_Silkscreen.gbr, Coaster_PCB_CDR-Edge_Cuts.gbr, Coaster_PCB_CDR-F_Cu.gbr, Coaster_PCB_CDR-F_Mask.gbr, Coaster_PCB_CDR-F_Paste.gbr]
2022-12-14 Updated Polygons and Vias
    [Coaster_PCB_CDR-B_Cu.gbr, Coaster_PCB_CDR-B_Mask.gbr, Coaster_PCB_CDR-B_Paste.gbr, Coaster_PCB_CDR-B_Silkscreen.gbr, Coaster_PCB_CDR-Edge_Cuts.gbr, Coaster_PCB_CDR-F_Cu.gbr, Coaster_PCB_CDR-F_Mask.gbr, Coaster_PCB_CDR-F_Paste.gbr]
2022-12-14 Updated Gerber Zip
    [Coaster_PCB_CDR-B_Cu.gbr, Coaster_PCB_CDR-B_Mask.gbr, Coaster_PCB_CDR-B_Paste.gbr, Coaster_PCB_CDR-B_Silkscreen.gbr, Coaster_PCB_CDR-Edge_Cuts.gbr, Coaster_PCB_CDR-F_Cu.gbr, Coaster_PCB_CDR-F_Mask.gbr, Coaster_PCB_CDR-F_Paste.gbr]
2022-12-14 Made cat outline PCB
    [Kitty_PCB-B_Cu.gbr, Kitty_PCB-B_Mask.gbr, Kitty_PCB-B_Paste.gbr, Kitty_PCB-B_Silkscreen.gbr, Kitty_PCB-Edge_Cuts.gbr, Kitty_PCB-F_Cu.gbr, Kitty_PCB-F_Mask.gbr, Kitty_PCB-F_Paste.gbr]
2022-12-14 Added some extra ground pins
    [Coaster_PCB_CDR-B_Cu.gbr, Coaster_PCB_CDR-B_Mask.gbr, Coaster_PCB_CDR-B_Paste.gbr, Coaster_PCB_CDR-B_Silkscreen.gbr, Coaster_PCB_CDR-Edge_Cuts.gbr, Coaster_PCB_CDR-F_Cu.gbr, Coaster_PCB_CDR-F_Mask.gbr, Coaster_PCB_CDR-F_Paste.gbr]
2022-12-21 Minor Updates, requested order
    [Coaster_PCB_CDR-B_Cu.gbr, Coaster_PCB_CDR-B_Mask.gbr, Coaster_PCB_CDR-B_Paste.gbr, Coaster_PCB_CDR-B_Silkscreen.gbr, Coaster_PCB_CDR-Edge_Cuts.gbr, Coaster_PCB_CDR-F_Cu.gbr, Coaster_PCB_CDR-F_Mask.gbr, Coaster_PCB_CDR-F_Paste.gbr]
2023-02-09 fixed overlapping zones
    [Coaster_PCB_CDR.kicad_pcb, Coaster_PCB_CDR.kicad_sch]
2023-02-09 removed pico smd pads
    [Coaster_PCB_CDR.kicad_pcb]
2023-02-09 added more polygons
    [Coaster_PCB_CDR.kicad_pcb, bom.csv, designators.csv, positions.csv]
2023-02-10 flipped hc05
    [Coaster_PCB_CDR.kicad_pcb]
2023-02-10 added more ground
    [Coaster_PCB_CDR.kicad_pcb]
2023-02-16 Removed extra stuff
    [Kitty_PCB-B_Cu.gbr, Kitty_PCB-B_Mask.gbr, Kitty_PCB-B_Paste.gbr, Kitty_PCB-B_Silkscreen.gbr, Kitty_PCB-Edge_Cuts.gbr, Kitty_PCB-F_Cu.gbr, Kitty_PCB-F_Mask.gbr, Kitty_PCB-F_Paste.gbr]
2023-03-08 changed pcb
    [Coaster_PCB_CDR.kicad_pcb, Coaster_PCB_CDR.kicad_sch]
2023-03-15 Updated PCB for FDR
    [Coaster_PCB_CDR.kicad_pcb, Coaster_PCB_CDR.kicad_sch, bom.csv, designators.csv, positions.csv]
2023-03-21 modified gnd vias
    [Coaster_PCB_CDR.kicad_pcb]
2023-03-22 decent amount of changes to board
    [Coaster_PCB_CDR.kicad_pcb]
2023-03-22 added jet switches
    [Coaster_PCB_CDR.kicad_pcb, Coaster_PCB_CDR.kicad_sch, bom.csv, designators.csv, positions.csv]
2023-03-22 jet switches
    [Coaster_PCB_CDR.kicad_sch]
2023-03-24 final please
    [Coaster_PCB_CDR.kicad_pcb, Coaster_PCB_CDR.kicad_sch, bom.csv, designators.csv, positions.csv]
2023-03-24 final finalish
    [Coaster_PCB_CDR.kicad_pcb, Coaster_PCB_CDR.kicad_sch]
2023-03-24 some refinements
    [Coaster_PCB_CDR.kicad_pcb, Coaster_PCB_CDR.kicad_sch, bom.csv, designators.csv, positions.csv]
2023-03-24 added vias
    [Coaster_PCB_CDR.kicad_pcb]
2023-03-25 removed edges
    [Coaster_PCB_CDR.kicad_pcb, positions.csv]
2023-03-28 done with fdr pcb?
    [Coaster_PCB_CDR.kicad_pcb, Coaster_PCB_CDR.kicad_sch, bom.csv, designators.csv, positions.csv]
2023-03-29 fdr pcb minimized
    [Coaster_PCB_CDR.kicad_pcb, Coaster_PCB_CDR.kicad_sch, bom.csv, designators.csv, positions.csv]
2023-03-30 changed LDO foot print
    [Coaster_PCB_CDR.kicad_pcb, Coaster_PCB_CDR.kicad_sch, bom.csv, designators.csv, positions.csv]
2023-03-30 added couple ceramics
    [Coaster_PCB_CDR.kicad_pcb, Coaster_PCB_CDR.kicad_sch, bom.csv, designators.csv, positions.csv]
2023-03-31 idk what changed
    [Coaster_PCB_CDR.kicad_pcb]
2023-04-25 pcb changes?
    [Coaster_PCB_CDR.kicad_pcb, positions.csv]
